ENG-ELSAYED-KANDIL/Scara-Robot/README.md

SCARA Robot (PRRR Configuration)
-----------------------------------------
🌟 Overview
----------------------------------------
This repository contains the design, build process, and control of a 4-DoF SCARA robot. The robot features a prismatic joint and three revolute joints (PRRR configuration) and is designed for precise pick-and-place tasks. It includes a functional GUI, real-time control, and an Arduino-based system for motor control.

<p align="center">
  SCARA Robot 1
  &nbsp;&nbsp;&nbsp;
  SCARA Robot 2
</p>

<p align="center"><strong>Figure 1: Final SCARA Robot</strong></p>

---
## 📖 1. Introduction  
This project focuses on building and analyzing a **SCARA (PRRR)** robot arm with **4 Degrees of Freedom (DoF)**. It combines both kinematic analysis and practical implementation, including calculations for forward kinematics, inverse kinematics, and Jacobian analysis. The project culminates in a demonstration where the robot performs precise pick-and-place tasks and can **hold objects weighing up to 1 kg**.

**This SCARA robot is developed for industrial pick-and-place applications.**  
The manipulator consists of:  
- **A prismatic joint** for vertical motion.  
- **Three revolute joints** for horizontal movements and rotation.  
- **A gripper** for handling square and round objects.  

The robot is controlled using an Arduino Uno and stepper motors through a CNC shield. The GUI simplifies user interaction, making the robot versatile for various tasks.  

---

## 🎯 2. Final Outcome  
The SCARA robot successfully performs pick-and-place tasks with smooth motion and precise control.  

https://github.com/user-attachments/assets/d78f2b1c-fb58-49c8-8bde-6cf13d8ed10f

*Figure 2: Final Robot Outcome*  

------
## 🔌 3. Wiring  

<p align="center">
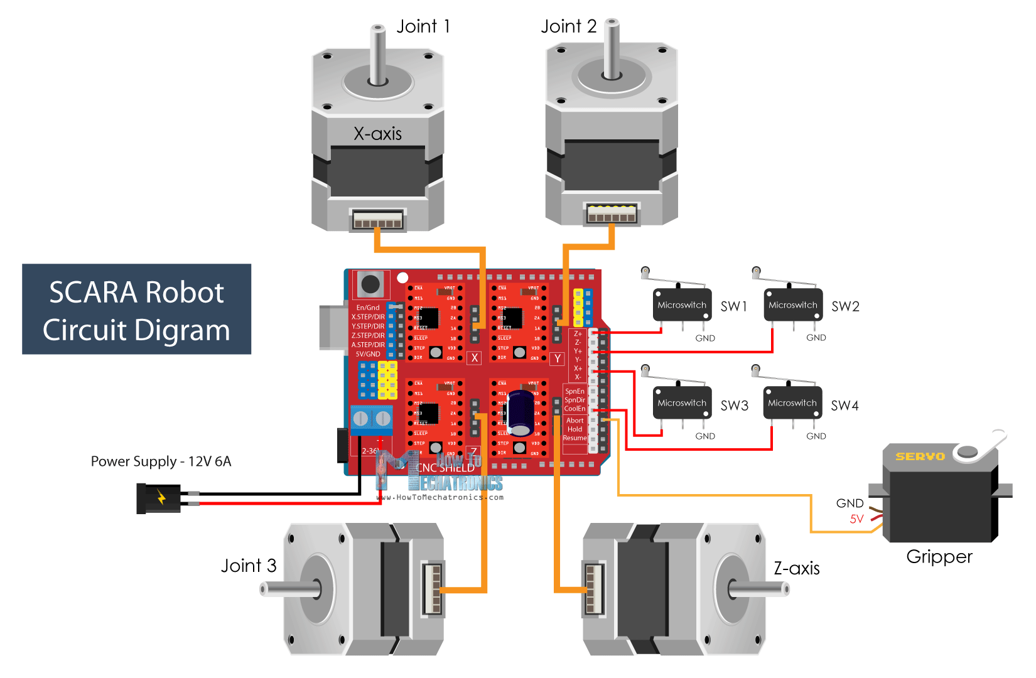
[picture p1: Pictures/Wiring.png]
  
</p>
<p align="center">
    <em>Figure 5: SCARA Robot main wiring diagram  </em>
</p>
<p align="center"> <em> Credit - how to mechatronics </em> </p>
 
The wiring connects stepper motors, the CNC shield, and the Arduino Uno. Here are the main considerations and steps followed:  

### **3.1 Motor Silence and Calibration**  
In wiring, I primarily focused on reducing motor noise. To achieve smooth motor operation, the current limit of the motor drivers was carefully adjusted. This calibration ensures precise motor activation. Setting an incorrect value can cause the motor drivers to overheat and potentially damage them. To further enhance motor precision, I adjusted the precision selector to 1/4 or 1/8 microstepping.

### **3.2 Connections and Testing**  
I connected the motor wiring as shown in the diagram and tested the connections with an oscilloscope and multimeter. Limit switches were placed at the corners of the joints' movement range to allow maximum rotational angles. After placing the limit switches, I assigned the pins for X+, Y+, Z+, and coolant functionalities.  

### **3.3 Servo Motor Powering**  
Since servo motors require a stable current, I initially tested them using the Arduino Uno with the CNC shield. However, the servo motor only received 3V from this setup, which was insufficient. To address this, I powered the servo motor separately using a 5V power supply.  

### **3.4 Power Supply Configuration**  
To power the entire system, which includes:  
- Four NEMA 17 stepper motors  
- Arduino Uno with CNC shield  
- Four motor drivers (DRV8825)  
- A servo motor  

I decided to use a 12V 10A power supply. A 12V 5A power supply would not have been sufficient to run all motors simultaneously.  

### **3.5 Cable Management**  
For clean and organized wiring, I used “Spiral Wire Wrapping Tube Cable Sleeves” and secured them with tie tags. This arrangement keeps the wires neat and minimizes clutter.  

### **3.6 Testing**  
To test all motors, I used simple Arduino code to verify their operation. This helped ensure that the motors, limit switches, and control pins were functioning as expected.  

### **3.7 Key Points**  
- **Shielded cables** were used for stepper motors to reduce electrical noise.  
- Correct polarity was ensured to avoid reversing motor directions.  
- The 12V DC power supply provided reliable power for the entire system.  

---

## 🏠 4. Homing Sequence
The homing sequence ensures that the robot starts from a known position:  

- The prismatic joint retracts to the lowest position.  
- Each revolute joint rotates to its home angle.  
- Limit switches provide feedback to confirm positions.  

As you can see in the video, the homing sequence begins with the gripper motor (joint 3). To determine the homing position, I used limit switches along with the following code:  
---

## 🏠 4. Homing Sequence
The homing sequence ensures that the robot starts from a known position:  

- The prismatic joint retracts to the lowest position.  
- Each revolute joint rotates to its home angle.  
- Limit switches provide feedback to confirm positions.  

As you can see in the video, the homing sequence begins with the gripper motor (joint 3). To determine the homing position, I used limit switches along with the following code:  

```cpp
//HOMING PROCESS
void homeRobot() {
  delay(1000);
  homeStepper2();
  homeStepper1();
  homeStepper3();
  homeStepperZ();
  isHomed = true;
  Serial.println("oK");
}

// joint 1
void homeStepper1() {
  stepper1.setCurrentPosition(0);
  stepper1.setSpeed(-1100);

  while (digitalRead(X_LIMIT_MIN) == 1) {
    stepper1.runSpeed();
  }

  delay(20);

  stepper1.setCurrentPosition(-maxDistance1);

  stepperPosition1 = 0;
  stepper1.moveTo(stepperPosition1);

  while (stepper1.currentPosition() != stepperPosition1) {
    stepper1.run();
  }

}

void homeStepper2() {
  stepper2.setCurrentPosition(0);
  stepper2.setSpeed(-1300);

  while (digitalRead(Y_LIMIT_MIN) == 1) {
    stepper2.runSpeed();
  }

  delay(20);

  stepper2.setCurrentPosition(-maxDistance2);

  stepperPosition2 = 0;
  stepper2.moveTo(stepperPosition2);

  while (stepper2.currentPosition() != stepperPosition2) {
    stepper2.run();
  }

}

//joint 3
void homeStepper3() {
  stepper3.setCurrentPosition(0);
  stepper3.setSpeed(-1300);

  while (digitalRead(GRIPPER_LIMIT) == 1) {
    stepper3.runSpeed();
  }

  delay(20);

  stepper3.setCurrentPosition(-maxDistance3);

  stepperPosition3 = 0;
  stepper3.moveTo(stepperPosition3);

  while (stepper3.currentPosition() != stepperPosition3) {
    stepper3.run();
  }
}

void homeStepperZ() {
  stepperZ.setCurrentPosition(0);
  stepperZ.setSpeed(1100);

  while (digitalRead(Z_LIMIT_MIN) == 1) {
    stepperZ.runSpeed();
  }

  delay(20);
  stepperZ.setCurrentPosition(0); /// max distance

  stepperZ.moveTo(maxDistanceZ); // 55 mm

  while (stepperZ.currentPosition() != maxDistanceZ) {
    stepperZ.run();
  }

}

```
**Homing** - https://github.com/ENG-ELSAYED-KANDIL/Scara-Robot/blob/main/Videos/WhatsApp%20Video%202025-06-26%20at%207.13.10%20PM.mp4
---
## 🧩 5. Pick and Place Application
The robot is programmed to pick objects from a defined source and place them in a target location.  

- Move to the pick position using the prismatic and revolute joints.  
- Grip the object using the servo-controlled gripper.  
- Transition to the target location and release the object.  

In the pick-and-place application, I saved 8 waypoints starting from its home position. Using the GUI, I configured these waypoints, which helped to better understand the movement of the joints and the gripper. After saving the waypoints and running the sequence, I achieved the following output:  

**Pick and Place Output** - https://github.com/ENG-ELSAYED-KANDIL/Scara-Robot/blob/main/Videos/pick%20%26%20place.mp4
---

## 🖥️ 6.**Graphical User Interface (GUI)**

<p align="center">
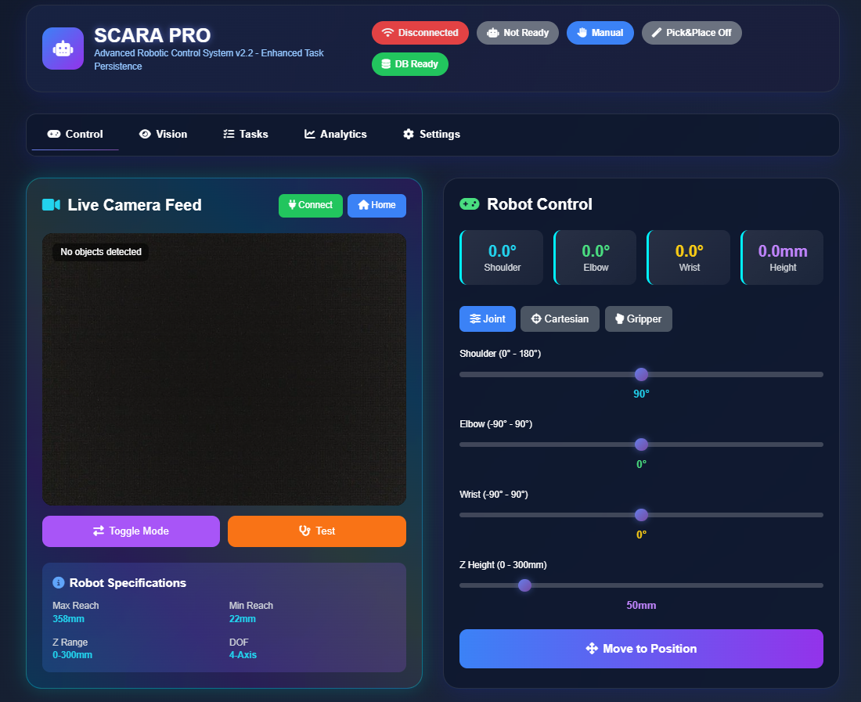
[picture p2: SCARA_ROBOT_GUI2/11.png]
SCARA Robot
  
</p>

A user-friendly GUI was developed using **Python**, designed to facilitate intuitive control and monitoring of the SCARA robot.

---

### **🔧 Key Features**

- 🎚️ **Joint Control**  
  Control robot joints individually using interactive sliders and buttons.

- 🎯 **End-Effector Positioning**  
  Direct control of the end-effector through coordinate input (X, Y, Z).

- 🎥 **Object Detection via Camera**  
  Real-time object detection using an integrated camera feed.

- 🧠 **Task Sequencing**  
  Ability to assign a sequence of tasks for the robot to execute automatically.

- 📈 **Real-Time Feedback**  
  Continuous monitoring of joint angles and current position.

- 🤖 **Gripper Control**  
  Open and close the gripper through simple GUI buttons.

---
## 🖨️ 7. 3D Printed Parts

The robot's design relies heavily on 3D-printed components, with over 100 hours of printing time invested to produce these parts. Each part was carefully designed to ensure functionality and precision:  

- **Gears**: Over seven different types of gears were printed to enable precise torque transfer and smooth motion across the joints.  
- **Link Components**: Critical parts for Link 1, Link 2, and Link 3 were printed to form the main structure of the robotic arm, allowing for stable and accurate joint movements.  
- **Z Holder**: This component supports the prismatic joint, ensuring reliable vertical motion and alignment.  
- **Limit Switch Contactors**: Custom 3D-printed parts that interact with limit switches to facilitate homing and accurate position detection.  
- **Gripper Mechanism**: Includes the gripping claws and structural supports necessary for securely holding objects during operation.  
- **Support Structures**: Temporary structures were printed alongside the main components to maintain the integrity of complex shapes during the printing process.  

These parts were printed using PLA+ material for durability and dimensional accuracy. All STL files are organized and available in the `/3D-Printed-Parts.rar` folder for easy access and replication.  

---

## 🔗 8. Code Explanation
The robot is programmed using Arduino Uno, with future plans to transition to AVR register-based programming for enhanced control. The key programming aspects include:  

- **Forward Kinematics**: Calculates the end-effector position based on joint values, ensuring precise movement to desired coordinates.  
- **Inverse Kinematics**: Determines joint angles for a given position, enabling accurate trajectory planning for the robot arm.  
- **DH Table and Jacobian Matrix**: The Denavit-Hartenberg (DH) parameters were derived to construct the transformation matrix, while the manipulator Jacobian was calculated to analyze joint velocities and forces.  
- **Control Algorithms**: Implements control for stepper motors, including speed adjustments and precise motion handling.  
- **Gripper Control**: Manages the servo-controlled gripper to open and close efficiently based on commands.  

To facilitate communication between the computer and the Arduino Uno, serial communication was established at a baud rate of 115200. This allows for easy command input and real-time control without needing to manually alter the code for each operation.  

Future iterations will focus on optimizing the code and exploring advanced microcontroller programming techniques for better performance.  

---

## 🎛️  9. Robot Details and Calculations

### **9.1 Link Dimensions and Specifications**  
The SCARA robot has **4 Degrees of Freedom (DoF)** with a **PRRR joint configuration**.  

**Link Dimensions**:  
- a1 = 150.8mm — Link 1 length  
- a2 = 190mm — Link 2 length  
- a3 = 160mm — Link 3 length  
- d4 = 600mm — Prismatic joint length   

### **9.2 Coordinate Frame Assignment**  
The following figure illustrates the coordinate frame assignment for the SCARA PRRR robot, adhering to the Denavit-Hartenberg (DH) convention:  

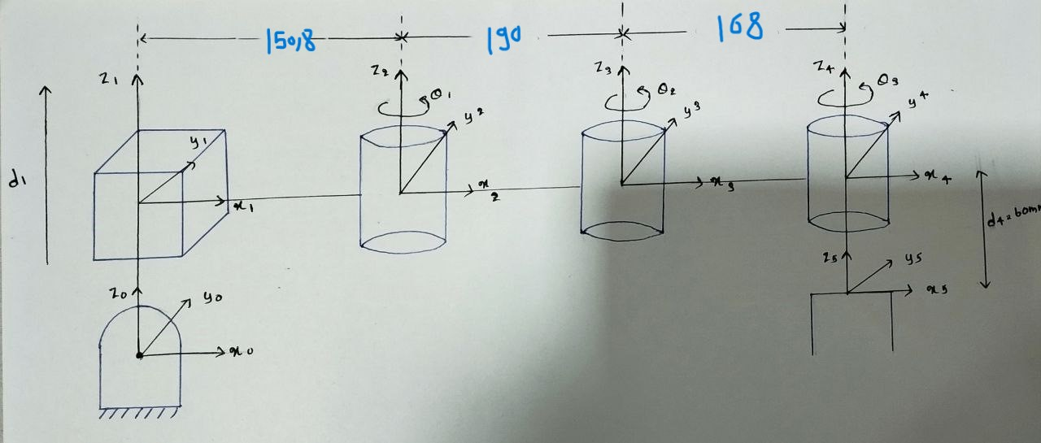
[picture p3: Pictures/Coordinate Frames.jpg]
Coordinate Frame Assignment
  

### **9.3 DH Table**  
The table below summarizes the DH parameters for the SCARA PRRR robot:  

| **Joint (i)** | **aᵢ (mm)** | **αᵢ (°)** | **dᵢ (mm)** | **θᵢ (°)** |
|---|---|---|---|---|
| 1 (Prismatic) | 0 | 0 | d₁ (variable) | 0 |
| 2 (Revolute) | 150.8 | 0 | 0 | θ₁ (variable) |
| 3 (Revolute) | 190 | 0 | 0 | θ₂ (variable) |
| 4 (Revolute) | 160 | 0 | 0 | θ₃ (variable) |
| 5 | 0 | 0 | 600 | 0 |

### **9.4Forward Kinematics**

Forward kinematics calculates the position and orientation of the end-effector based on the joint angles and link lengths. Using Denavit-Hartenberg (DH) parameters, we define the transformation matrix for each joint. The transformation matrix is:

<p align="center">
  SCARA Robot
</p>
By multiplying the individual transformation matrices from base to end-effector, we get the final transformation matrix T . This matrix provides the position (x, y, z) and the orientation of the end-effector. The angles θ1, θ2, and θ3 are used to determine the robot’s orientation in space.

<p align="center">
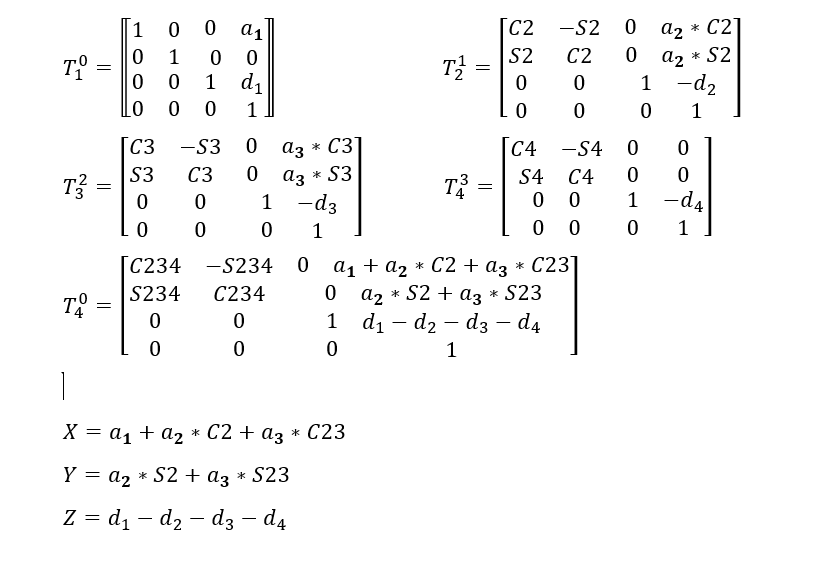
[picture p4: Pictures/forward.png]
  
</p>

### **9.5Inverse Kinematics**

Inverse kinematics determines the required joint angles based on the desired position of the end-effector. Given the end-effector's target position (x, y, z), and using the known link lengths, we calculate the angles θ₁, θ₂, and the displacement d₄ (for prismatic joints if applicable).

The inverse kinematics process involves solving geometric equations or using trigonometric identities to find the joint variables that place the end-effector at the desired location. For a SCARA robot, this typically involves solving for:

θ₁ and θ₂ using planar geometry in the x-y plane

d₄ from the z-position of the end-effector

<p align="center">
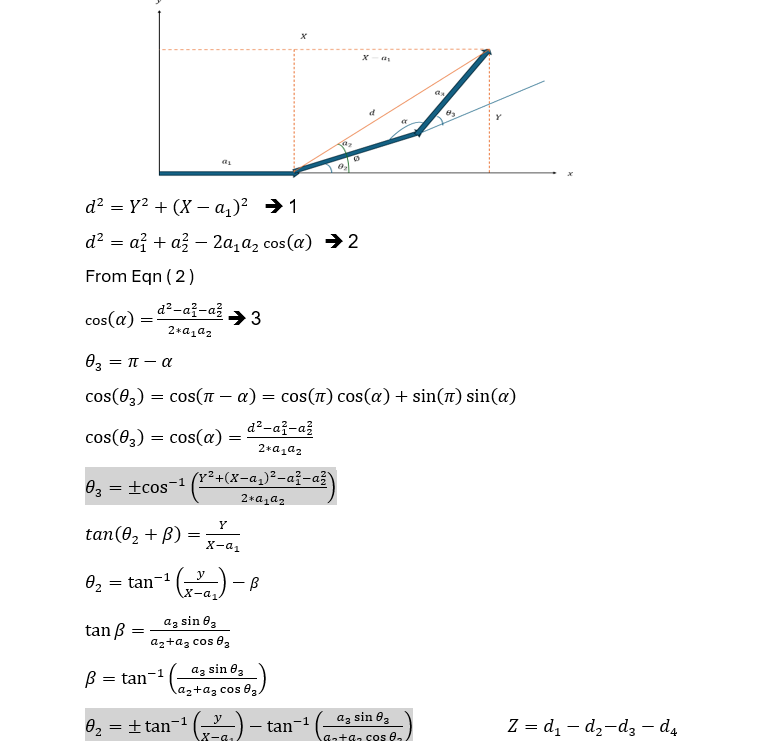
[picture p5: Pictures/inverse.png]
  
</p>

The Jacobian is derived using the partial derivatives of the forward kinematics equations.  

### **9.6Manipulator Jacobian Matrix**
The Jacobian matrix relates joint velocities to end-effector velocities. It is essential for analyzing the robot’s motion and controlling its speed and acceleration. For a PRRR manipulator, the Jacobianmatrix has two parts:

- Linear Velocity: The part of the Jacobian that maps joint velocities to linear velocities of the end-effector. It involves the cross product between the joint axes and the position vector.
- Angular Velocity: The part that maps joint velocities to angular velocities.

The Jacobian for the SCARA robot is given by:

<p align="center">
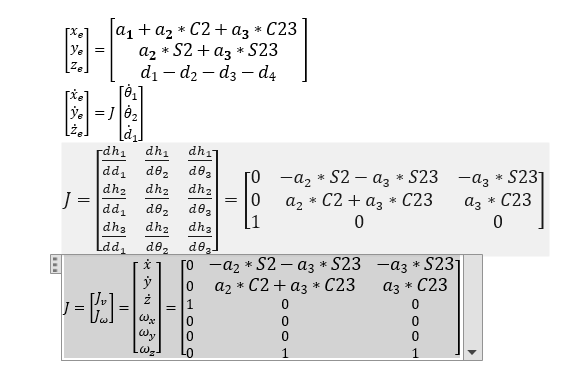
[picture p6: Pictures/jacobian.png]
  
</p>

### **9.6Dynamics Equations**



The solution is here :[Link](https://github.com/ENG-ELSAYED-KANDIL/Scara-Robot/blob/main/kinematics%20and%20Dynamics%20by%20write/dynamics.pdf) 

### **9.7Computed Torque Control**
Computed Torque Control is a model-based control strategy used to control the motion of robotic manipulators. The key idea behind CTC is to compensate for the robot's dynamics by applying the necessary torques at the joints to achieve a desired trajectory.
CTC involves:
Trajectory Planning: A desired trajectory or reference trajectory is defined for the robot, usually in terms of joint angles, velocities, and accelerations.
Inverse kinematics: Inverse kinematics is used to calculate the joint angles required to achieve a specific end-effector position. Small errors in these calculations can lead to significant deviations in the robot's movement.
Modeling Dynamics: The robot's dynamics are modeled, typically using the inverse dynamics equations. This allows for the computation of the torques required to track the desired trajectory.
Feedback Control: A feedback loop is used to adjust the control input in real-time. The control input typically involves both the desired torques (calculated from the inverse dynamics) and any necessary feedback gains (like PD or PID control).
Forward kinematics : used to calculate the final position and orientation of the robot's end-effector based on the angles or displacements of each joint in the robotic arm.

### **9.8Simulink Simulation**


System Simulation:

https://github.com/user-attachments/assets/358b40ac-75ad-4ba7-8ce4-bd9f127024b1

---

## 🤖 10. References  
- SCARA Robot Design Basics: [Link](https://en.wikipedia.org/wiki/SCARA)
- SCARA Robot Design Basics2: [Link](https://github.com/ENG-ELSAYED-KANDIL/Scara-Robot/upload/main)  
- Arduino CNC Shield Documentation: [Link](https://www.aranacorp.com/en/using-an-arduino-cnc-shield-v3)  
- SCARA Robot | How To Build Your Own Arduino Based Robot: [Link](https://youtu.be/1QHJksTrk8s?si=geVqN3zxPEzTnQR-)

---

Feel free to raise issues or contribute improvements to this project!
