ENG-ELSAYED-KANDIL/Scara-Robot/kinematics and Dynamics by write/inverse.pdf

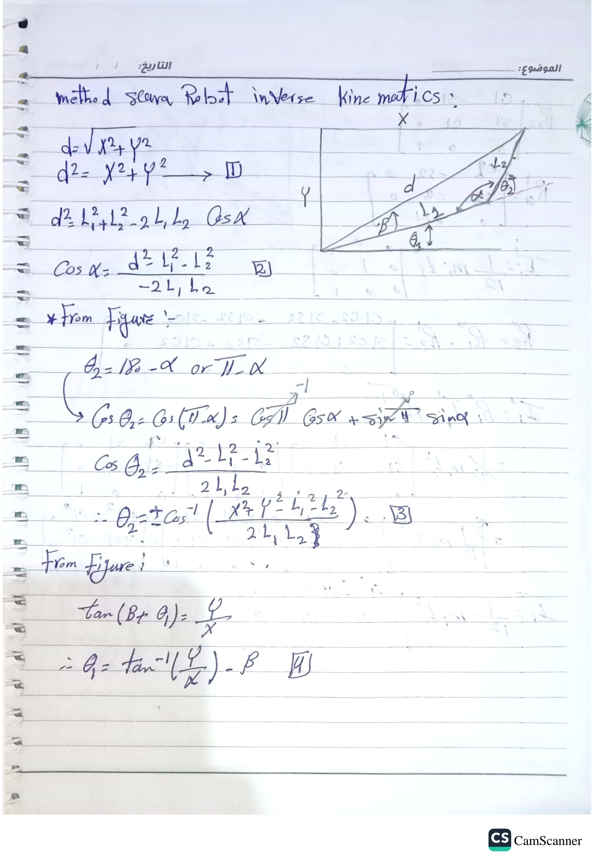
[picture p7: page 1]

CamScanner (https://v3.camscanner.com/user/download)

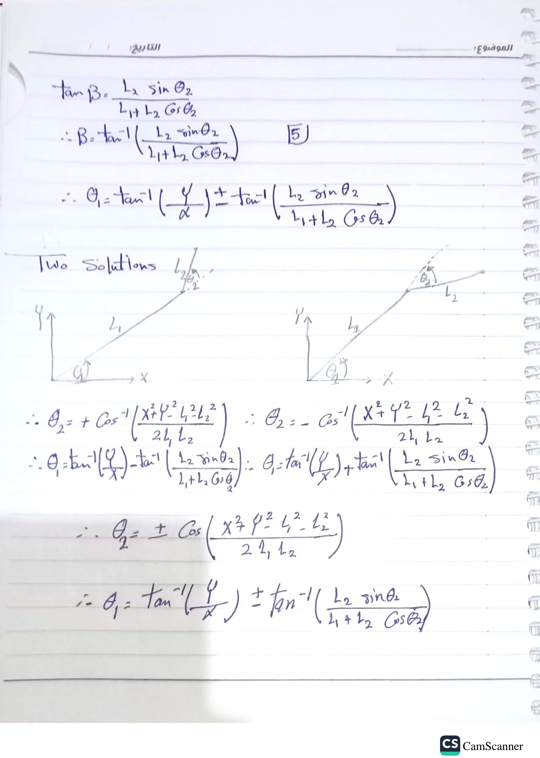
[picture p8: page 2]

CamScanner (https://v3.camscanner.com/user/download)
