ENG-ELSAYED-KANDIL/Scara-Robot/Pictures/photo_2025-07-09_03-17-51.jpg

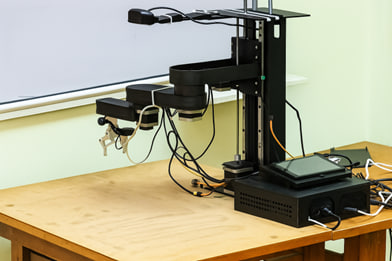
Pictures/photo_2025-07-09_03-17-51.jpg
