ENG-ELSAYED-KANDIL/Scara-Robot/Pictures/photo_2025-07-09_17-01-57.jpg

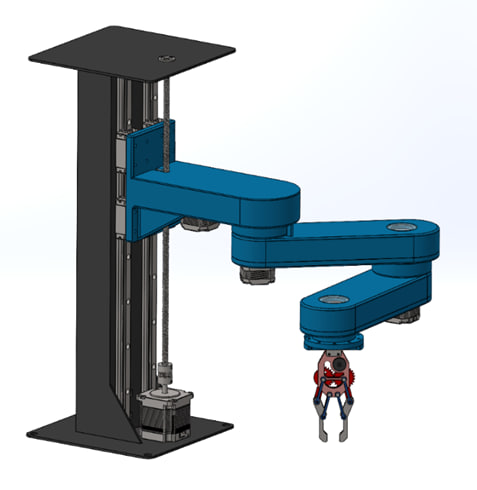
Pictures/photo_2025-07-09_17-01-57.jpg
