ENG-ELSAYED-KANDIL/Scara-Robot/Pictures/photo_2025-07-09_17-06-35.jpg

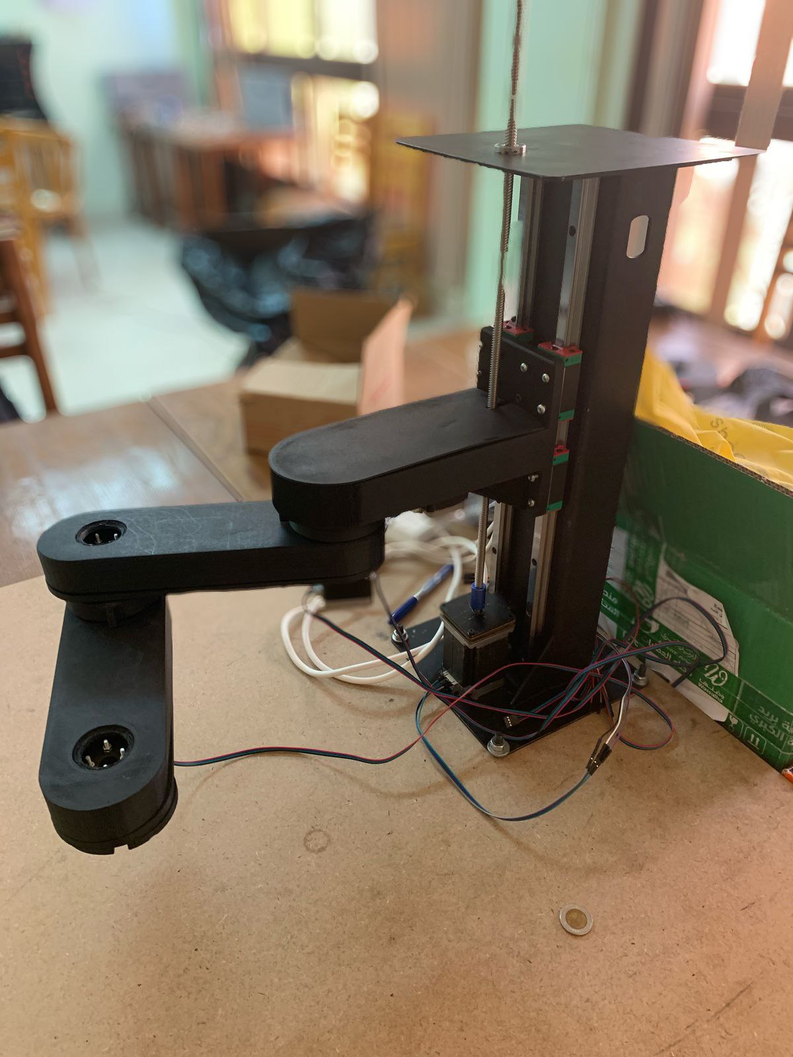
Pictures/photo_2025-07-09_17-06-35.jpg
