ENG-ELSAYED-KANDIL/Scara-Robot/SCARA_ROBOT_GUI1/scara_GUI.png

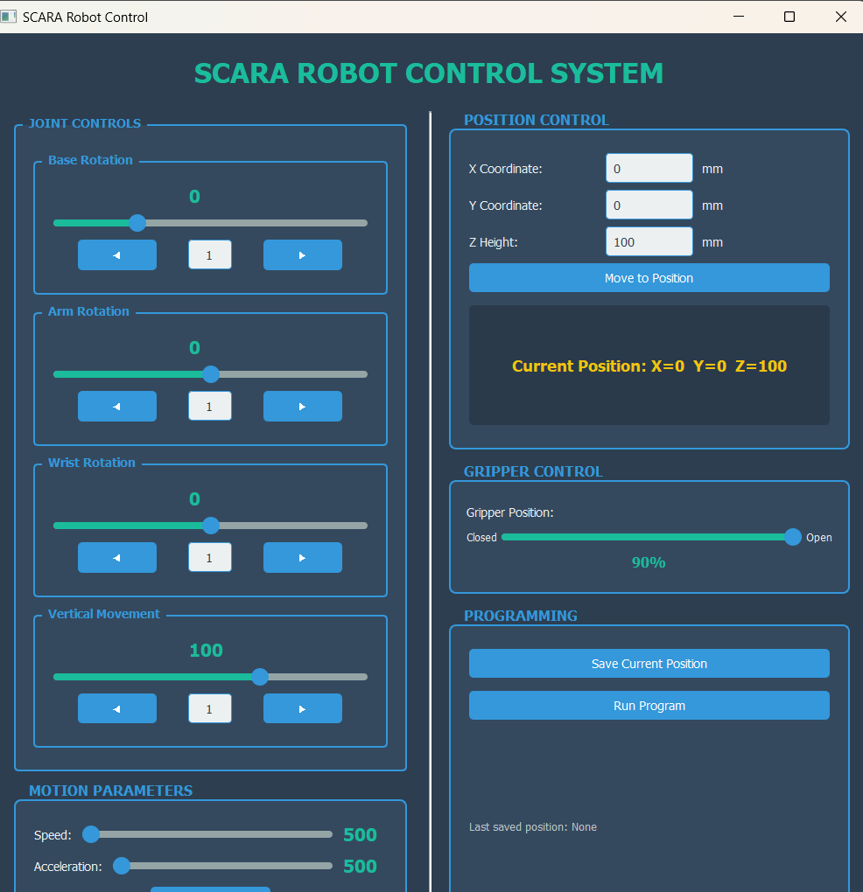
SCARA_ROBOT_GUI1/scara_GUI.png
