ENG-ELSAYED-KANDIL/Scara-Robot/SCARA_ROBOT_GUI2/1.png

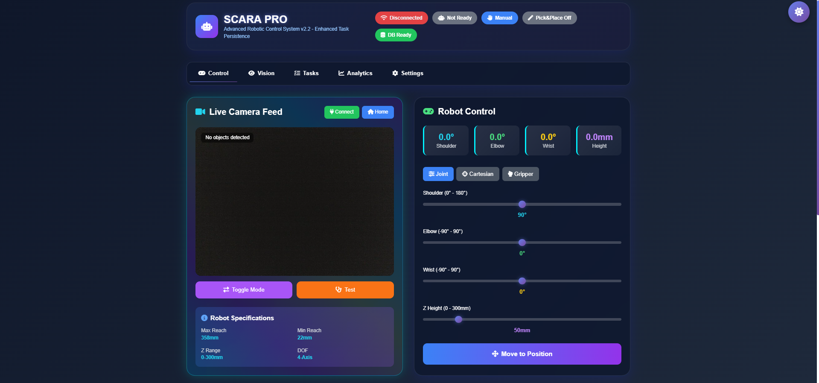
SCARA_ROBOT_GUI2/1.png
