ENG-ELSAYED-KANDIL/Scara-Robot/SCARA_ROBOT_GUI2/2.png

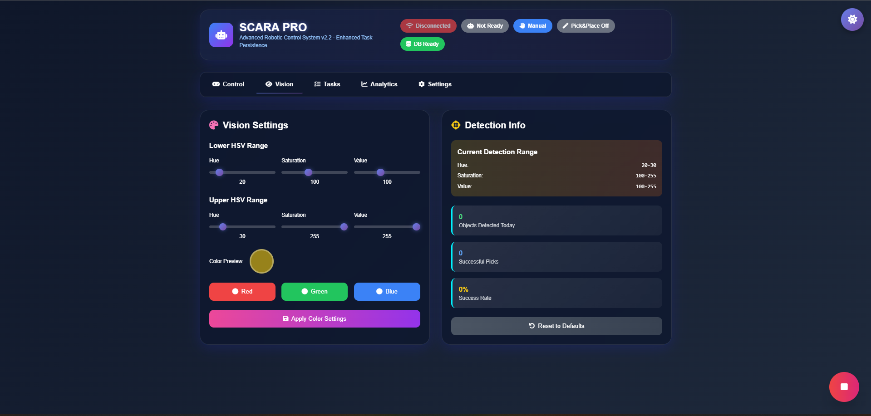
SCARA_ROBOT_GUI2/2.png
