ENG-ELSAYED-KANDIL/Scara-Robot/SCARA_ROBOT_GUI2/3.png

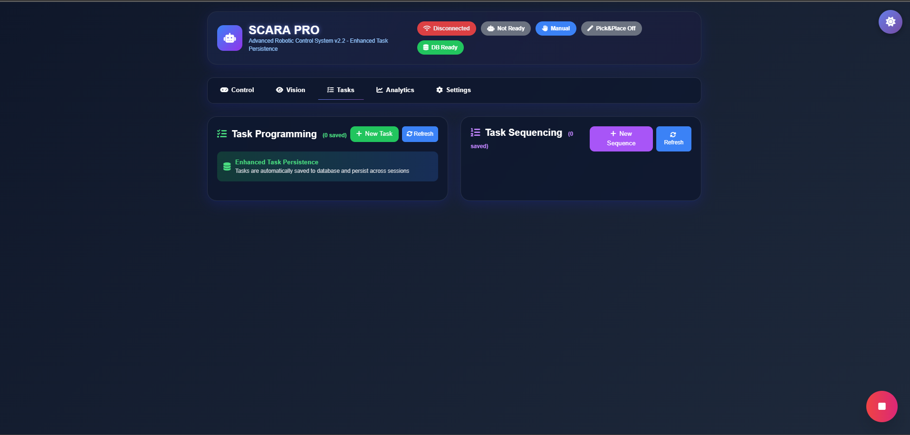
SCARA_ROBOT_GUI2/3.png
