ENG-ELSAYED-KANDIL/Scara-Robot/SCARA_ROBOT_GUI2/4.png

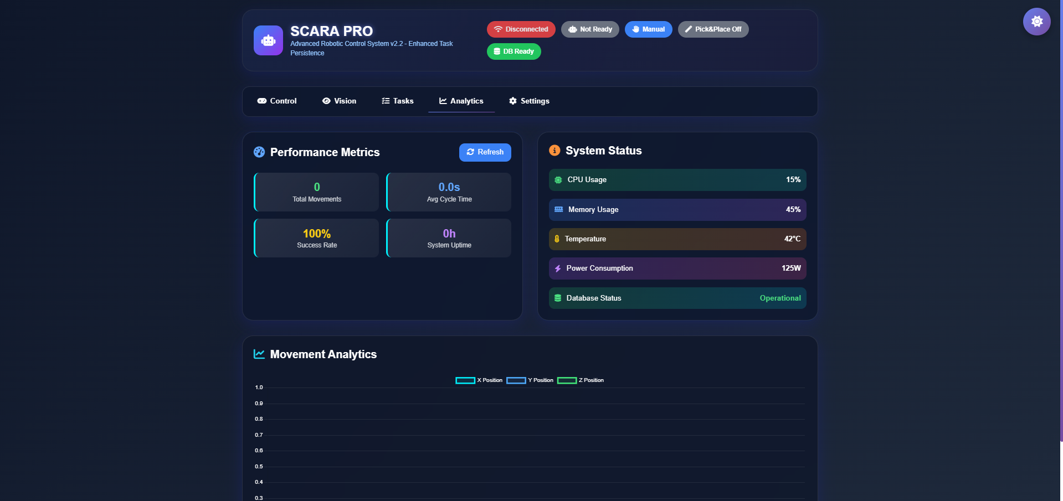
SCARA_ROBOT_GUI2/4.png
