ENG-ELSAYED-KANDIL/Scara-Robot/SCARA_ROBOT_GUI2/5.png

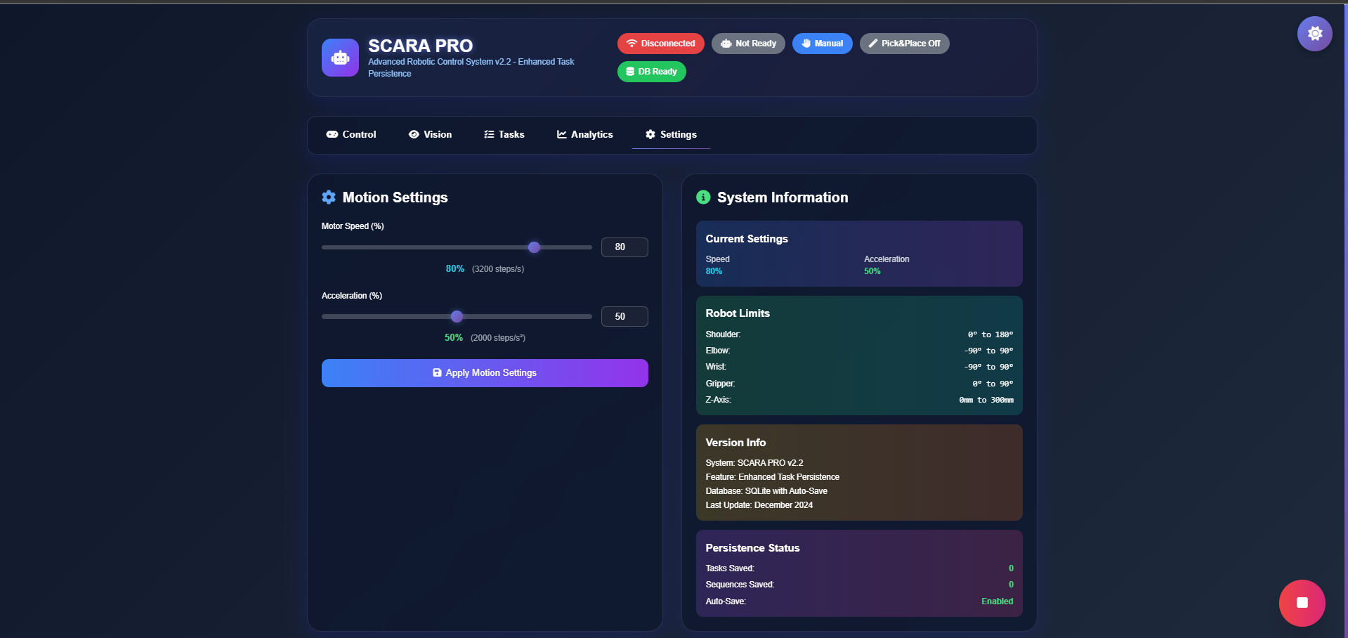
SCARA_ROBOT_GUI2/5.png
