ENG-ELSAYED-KANDIL/Scara-Robot/SCARA_ROBOT_GUI2/main.py

import asyncio
import json
import logging
import math
import sqlite3
import threading
import time
from dataclasses import dataclass, asdict
from datetime import datetime
from pathlib import Path
from typing import Dict, List, Optional, Tuple, Any
import queue

import cv2
import numpy as np
import serial
from flask import Flask, Response, jsonify, request, render_template_string
from flask_socketio import SocketIO, emit
import matplotlib

matplotlib.use('Agg')
import matplotlib.pyplot as plt
from matplotlib.backends.backend_agg import FigureCanvasAgg
import io
import base64

# Try to import numpy for kinematics calculations
try:
    import numpy as np

    NUMPY_AVAILABLE = True
except ImportError:
    NUMPY_AVAILABLE = False
    print("Warning: NumPy not available. Some kinematics functions may not work properly.")


@dataclass
class RobotConfig:
    """Robot physical configuration"""
    arm1_length: float = 190.0
    arm2_length: float = 168.0
    max_z_height: float = 300.0  # Updated to 300mm
    steps_per_degree: float = 8.888
    steps_per_mm_z: float = 80.0

    @property
    def max_reach(self) -> float:
        return self.arm1_length + self.arm2_length

    @property
    def min_reach(self) -> float:
        return abs(self.arm1_length - self.arm2_length)


@dataclass
class MotionSettings:
    """Motion control settings"""
    max_speed: int = 80  # Percentage (0-100)
    acceleration: int = 50  # Percentage (0-100)
    jog_speed: int = 800
    approach_speed: int = 500
    safety_limits_enabled: bool = True

    # Actual speed/acceleration values for display
    @property
    def actual_speed(self) -> float:
        """Convert percentage to actual steps/second (0-4000)"""
        return (self.max_speed / 100.0) * 4000.0

    @property
    def actual_acceleration(self) -> float:
        """Convert percentage to actual steps/second² (0-4000)"""
        return (self.acceleration / 100.0) * 4000.0


@dataclass
class VisionSettings:
    """Computer vision settings"""
    camera_index: int = 0
    resolution: Tuple[int, int] = (640, 480)
    hsv_lower: List[int] = None
    hsv_upper: List[int] = None
    blur_kernel: int = 5
    min_contour_area: int = 500
    calibration_matrix: Optional[np.ndarray] = None

    def __post_init__(self):
        if self.hsv_lower is None:
            self.hsv_lower = [20, 100, 100]
        if self.hsv_upper is None:
            self.hsv_upper = [30, 255, 255]


@dataclass
class SystemState:
    """Current system state"""
    is_connected: bool = False
    is_homed: bool = False
    emergency_stop: bool = False
    motors_enabled: bool = False
    operation_mode: str = "manual"
    current_position: List[float] = None
    target_position: List[float] = None
    gripper_position: int = 0
    ultrasonic_distance: float = 0.0
    last_detection: Optional[Tuple[float, float]] = None
    system_errors: List[str] = None
    pick_and_place_enabled: bool = False
    is_executing_pickplace: bool = False
    is_executing_sequence: bool = False
    current_sequence_task: Optional[str] = None
    sequence_progress: Dict = None

    def __post_init__(self):
        if self.current_position is None:
            self.current_position = [0.0, 0.0, 0.0, 0.0]
        if self.target_position is None:
            self.target_position = [0.0, 0.0, 0.0, 0.0]
        if self.system_errors is None:
            self.system_errors = []
        if self.sequence_progress is None:
            self.sequence_progress = {
                'current_task': 0,
                'current_loop': 0,
                'total_loops': 0,
                'is_running': False,
                'is_paused': False
            }


@dataclass
class PickPlaceSettings:
    """Pick and place operation settings"""
    pick_z_height: float = 50.0
    drop_x: float = 20.0
    drop_y: float = 10.0
    drop_z: float = 20.0
    grip_position: int = 45  # Updated range 0-90
    open_position: int = 0
    pick_delay: float = 1.0
    drop_delay: float = 1.0
    approach_height: float = 80.0
    auto_mode: bool = False


class RobotController:
    """Main robot controller class with enhanced functionality"""

    def __init__(self, config: RobotConfig, port: str = '/dev/ttyUSB0', baudrate: int = 115200):
        self.config = config
        self.port = port
        self.baudrate = baudrate
        self.serial_connection: Optional[serial.Serial] = None
        self.command_queue = queue.Queue()
        self.response_queue = queue.Queue()
        self.is_running = False
        self.lock = threading.Lock()

        # Pick and place settings
        self.pickplace_settings = PickPlaceSettings()

        self.logger = logging.getLogger(__name__)

    async def connect(self) -> bool:
        """Establish connection to Arduino"""
        try:
            ports_to_try = ['/dev/ttyACM0', self.port, '/dev/ttyUSB0', '/dev/ttyUSB1', 'COM8', 'COM4', 'COM5']

            for port in ports_to_try:
                try:
                    self.logger.info(f"Attempting to connect to port: {port}")

                    self.serial_connection = serial.Serial(
                        port,
                        self.baudrate,
                        timeout=2.0,
                        write_timeout=2.0,
                        bytesize=serial.EIGHTBITS,
                        parity=serial.PARITY_NONE,
                        stopbits=serial.STOPBITS_ONE
                    )

                    await asyncio.sleep(3)

                    self.serial_connection.reset_input_buffer()
                    self.serial_connection.reset_output_buffer()

                    for attempt in range(3):
                        self.logger.info(f"Connection attempt {attempt + 1}/3")

                        response = await self.send_command("GET_STATUS", timeout=3.0)

                        if response and ("STATUS:" in response or "SCARA_READY" in response or "OK" in response):
                            self.is_running = True
                            self.port = port
                            self.logger.info(f"Successfully connected to robot on port {port}")
                            return True

                        response = await self.send_command("PING", timeout=2.0)
                        if response:
                            self.is_running = True
                            self.port = port
                            self.logger.info(f"Connected to device on port {port} (responded to PING)")
                            return True

                        await asyncio.sleep(1)

                    if self.serial_connection and self.serial_connection.is_open:
                        self.serial_connection.close()

                except serial.SerialException as se:
                    self.logger.warning(f"Failed to connect to {port}: {se}")
                    if self.serial_connection and self.serial_connection.is_open:
                        self.serial_connection.close()
                    continue
                except Exception as e:
                    self.logger.warning(f"Unexpected error with port {port}: {e}")
                    if self.serial_connection and self.serial_connection.is_open:
                        self.serial_connection.close()
                    continue

            self.logger.error("Failed to connect to any serial port")

        except Exception as e:
            self.logger.error(f"Connection failed: {e}")

        return False

    async def disconnect(self):
        """Disconnect from Arduino"""
        self.is_running = False
        if self.serial_connection and self.serial_connection.is_open:
            self.serial_connection.close()
            self.logger.info("Disconnected from robot")

    async def send_command(self, command: str, timeout: float = 5.0) -> Optional[str]:
        """Send command to Arduino and wait for response"""
        if not self.serial_connection or not self.serial_connection.is_open:
            return None

        try:
            with self.lock:
                self.serial_connection.reset_input_buffer()

                self.serial_connection.write(f"{command}\n".encode('utf-8'))
                self.serial_connection.flush()

                start_time = time.time()
                while time.time() - start_time < timeout:
                    if self.serial_connection.in_waiting > 0:
                        try:
                            raw_data = self.serial_connection.readline()

                            try:
                                response = raw_data.decode('utf-8').strip()
                            except UnicodeDecodeError:
                                try:
                                    response = raw_data.decode('latin-1').strip()
                                    self.logger.warning(f"Used latin-1 encoding for response: {response}")
                                except UnicodeDecodeError:
                                    response = raw_data.decode('utf-8', errors='ignore').strip()
                                    self.logger.warning(f"Ignored decode errors for response: {response}")

                            if response:
                                self.logger.debug(f"Command: {command} -> Response: {response}")
                                return response

                        except Exception as decode_error:
                            self.logger.error(f"Response decode error: {decode_error}")
                            continue

                    await asyncio.sleep(0.01)

        except Exception as e:
            self.logger.error(f"Command send error: {e}")

        return None

    async def home_robot(self) -> bool:
        """Home the robot to its reference position"""
        self.logger.info("Starting homing sequence")

        response = await self.send_command("HOME", timeout=30.0)

        if response:
            self.logger.debug(f"Homing response: {response}")

            if any(keyword in response for keyword in ["OK", "HOMING COMPLETED", "HOME COMPLETE", "HOMED"]):
                self.logger.info("Homing completed successfully")
                return True
            elif "ERROR" in response:
                self.logger.error(f"Homing failed with error: {response}")
                return False
            elif "INFO" in response or "WARNING" in response:
                self.logger.info(f"Homing in progress: {response}")

                final_response = await self.send_command("GET_STATUS", timeout=5.0)
                if final_response and "homed=1" in final_response:
                    self.logger.info("Homing completed (confirmed via status)")
                    return True
                else:
                    self.logger.warning("Homing status unclear, but proceeding")
                    return True
            else:
                self.logger.warning(f"Unexpected homing response: {response}")
                return True
        else:
            self.logger.error("No response received from homing command")
            return False

    async def move_joint(self, shoulder: float, elbow: float, wrist: float, z: float) -> bool:
        """Move robot using joint coordinates with updated limits"""
        self.logger.info(f"Attempting joint movement: S={shoulder:.2f}°, E={elbow:.2f}°, W={wrist:.2f}°, Z={z:.2f}mm")

        # Updated validation ranges
        if not (0 <= shoulder <= 180):  # Updated: 0 to 180 degrees
            self.logger.error(f"Shoulder angle {shoulder}° out of range (0 to 180)")
            return False
        if not (-90 <= elbow <= 90):  # Same as before
            self.logger.error(f"Elbow angle {elbow}° out of range (-90 to 90)")
            return False
        if not (-90 <= wrist <= 90):  # Updated: -90 to 90 degrees
            self.logger.error(f"Wrist angle {wrist}° out of range (-90 to 90)")
            return False
        if not (0 <= z <= 300):  # Updated: 0 to 300 mm
            self.logger.error(f"Z height {z}mm out of range (0 to 300)")
            return False

        command = f"MOVE_JOINT S{shoulder:.2f} B{elbow:.2f} W{wrist:.2f} Z{z:.2f}"
        self.logger.debug(f"Sending command: {command}")

        response = await self.send_command(command, timeout=10.0)

        if response:
            self.logger.debug(f"Robot response: {response}")
            if "OK" in response:
                self.logger.info("Joint movement successful")
                return True
            elif "ERROR" in response:
                self.logger.error(f"Robot reported error: {response}")

                if "not homed" in response.lower():
                    self.logger.info("Robot needs to be homed first")

                return False
            else:
                self.logger.warning(f"Unexpected response: {response}")
                return True
        else:
            self.logger.error("No response received from robot")
            return False

    async def move_cartesian(self, x: float, y: float, z: float) -> bool:
        """Move robot using Cartesian coordinates with improved inverse kinematics"""
        self.logger.info(f"Attempting Cartesian movement to: X={x:.2f}mm, Y={y:.2f}mm, Z={z:.2f}mm")

        # Calculate inverse kinematics
        success, theta1, theta2, phi, final_z = self.inverse_kinematics(x, y, z)

        if not success:
            self.logger.error(f"Cannot reach position ({x:.2f}, {y:.2f}, {z:.2f})")
            return False

        # Verify the solution with forward kinematics
        verify_x, verify_y = self.forward_kinematics(theta1, theta2, phi)
        error = math.sqrt((x - verify_x) ** 2 + (y - verify_y) ** 2)

        if error > 4.0:  # Allow 4mm tolerance
            self.logger.warning(f"IK solution has {error:.4f}mm error")

        self.logger.info(
            f"IK Solution: Shoulder={theta1:.1f}°, Elbow={theta2:.1f}°, Wrist={phi:.1f}°, Error={error:.2f}mm")

        # Use the joint movement command with calculated angles
        return await self.move_joint(theta1, theta2, phi, final_z)

    async def control_gripper(self, position: int) -> bool:
        """Control gripper position with updated range (0-90 degrees)"""
        # Updated validation range
        if not (0 <= position <= 90):  # Updated: 0 to 90 degrees
            self.logger.error(f"Gripper position {position}° out of range (0 to 90)")
            return False

        command = f"GRIPPER {position}"
        response = await self.send_command(command)

        return response and "OK" in response

    async def set_motion_settings(self, speed: int, acceleration: int) -> bool:
        """Set motion speed and acceleration (percentages, converted to actual values)"""
        # Validate ranges (0-100 percentages)
        speed = max(0, min(100, speed))
        acceleration = max(0, min(100, acceleration))

        # Convert percentages to actual values for Arduino
        actual_speed = (speed / 100.0) * 4000.0
        actual_acceleration = (acceleration / 100.0) * 4000.0

        command = f"SET_MOTION SPEED{actual_speed:.0f} ACCEL{actual_acceleration:.0f}"
        response = await self.send_command(command)

        return response and "OK" in response

    # === IMPROVED INVERSE KINEMATICS IMPLEMENTATION ===

    def inverse_kinematics(self, x: float, y: float, z: float = None) -> Tuple[bool, float, float, float, float]:
        """
        Improved inverse kinematics for SCARA robot with corrected equations

        Args:
            x, y: Target Cartesian coordinates in mm
            z: Target Z height in mm (optional, defaults to current or 50mm)

        Returns:
            Tuple of (success, theta1, theta2, phi, z) where:
            - theta1: shoulder angle in degrees (0 to 180)
            - theta2: elbow angle in degrees (-90 to 90)
            - phi: gripper orientation angle in degrees (-90 to 90)
            - z: vertical position in mm (0 to 300)
        """
        try:
            # Use numpy if available, otherwise fall back to math
            if NUMPY_AVAILABLE:
                import numpy as np
                sqrt_func = np.sqrt
                clip_func = np.clip
                arccos_func = np.arccos
                arctan2_func = np.arctan2
                sin_func = np.sin
                cos_func = np.cos
                radians_func = np.radians
                degrees_func = np.degrees
            else:
                sqrt_func = math.sqrt

                def clip_func(val, min_val, max_val):
                    return max(min_val, min(max_val, val))

                arccos_func = math.acos
                arctan2_func = math.atan2
                sin_func = math.sin
                cos_func = math.cos
                radians_func = math.radians
                degrees_func = math.degrees

            # Robot arm lengths and limits
            L1 = self.config.arm1_length  # 190mm
            L2 = self.config.arm2_length  # 168mm
            MAX_REACH = L1 + L2  # 358mm
            MIN_REACH = abs(L1 - L2)  # 22mm

            # Set default Z if not provided
            if z is None:
                z = 50.0  # Default height

            # Validate Z height with new range
            if not (0 <= z <= self.config.max_z_height):
                self.logger.warning(f"Z height {z}mm out of range (0 to {self.config.max_z_height})")
                return False, 0.0, 0.0, 0.0, z

            # Check if point is reachable
            distance = sqrt_func(x * x + y * y)
            if distance > MAX_REACH or distance < MIN_REACH:
                self.logger.warning(f"Target position ({x}, {y}) is out of reachable workspace")
                return False, 0.0, 0.0, 0.0, z

            # Improved inverse kinematics calculation
            # Calculate elbow angle using law of cosines
            cos_theta2 = (distance * distance - L1 * L1 - L2 * L2) / (2 * L1 * L2)
            cos_theta2 = clip_func(cos_theta2, -1.0, 1.0)  # Ensure valid range for acos

            # Calculate two possible solutions for elbow
            theta2_1 = arccos_func(cos_theta2)  # Elbow up configuration
            theta2_2 = -arccos_func(cos_theta2)  # Elbow down configuration

            # Choose elbow configuration based on workspace
            theta2 = theta2_1 if theta2_1 <= math.pi / 2 else theta2_2

            # Calculate shoulder angle
            alpha = arctan2_func(y, x)
            beta = arctan2_func(L2 * sin_func(theta2), L1 + L2 * cos_func(theta2))
            theta1 = alpha - beta

            # Convert to degrees
            theta1_deg = degrees_func(theta1)
            theta2_deg = degrees_func(theta2)

            # Normalize shoulder angle to 0-180 range
            while theta1_deg < 0:
                theta1_deg += 360
            while theta1_deg > 180:
                theta1_deg -= 360

            # If still out of range, try the other elbow configuration
            if theta1_deg < 0 or theta1_deg > 180:
                theta2 = theta2_2 if theta2 == theta2_1 else theta2_1
                beta = arctan2_func(L2 * sin_func(theta2), L1 + L2 * cos_func(theta2))
                theta1 = alpha - beta
                theta1_deg = degrees_func(theta1)
                theta2_deg = degrees_func(theta2)

                # Normalize again
                while theta1_deg < 0:
                    theta1_deg += 360
                while theta1_deg > 180:
                    theta1_deg -= 360

            # Calculate wrist orientation (phi) to keep end-effector parallel to base
            # For a SCARA robot, phi should compensate for shoulder and elbow rotation
            phi = -(theta1_deg + theta2_deg)

            # Normalize phi to -90 to 90 range
            while phi > 90:
                phi -= 180
            while phi < -90:
                phi += 180

            # Round values for consistency
            theta1_deg = round(theta1_deg, 2)
            theta2_deg = round(theta2_deg, 2)
            phi = round(phi, 2)

            # Validate final angles are within joint limits
            if not (0 <= theta1_deg <= 180):
                self.logger.warning(f"Shoulder angle {theta1_deg}° out of range (0-180)")
                return False, 0.0, 0.0, 0.0, z

            if not (-90 <= theta2_deg <= 90):
                self.logger.warning(f"Elbow angle {theta2_deg}° out of range (-90-90)")
                return False, 0.0, 0.0, 0.0, z

            if not (-90 <= phi <= 90):
                self.logger.warning(f"Wrist angle {phi}° out of range (-90-90)")
                return False, 0.0, 0.0, 0.0, z

            self.logger.info(
                f"IK Solution: ({x:.1f}, {y:.1f}, {z:.1f}) -> Shoulder: {theta1_deg}°, Elbow: {theta2_deg}°, Wrist: {phi}°")
            return True, theta1_deg, theta2_deg, phi, z

        except Exception as e:
            self.logger.error(f"Inverse kinematics calculation error: {e}")
            return False, 0.0, 0.0, 0.0, z if z is not None else 50.0

    def forward_kinematics(self, shoulder_deg: float, elbow_deg: float, wrist_deg: float = 0.0) -> Tuple[float, float]:
        """
        Calculate forward kinematics for SCARA robot (verified and corrected)

        Args:
            shoulder_deg, elbow_deg, wrist_deg: Joint angles in degrees

        Returns:
            Tuple of (x, y) Cartesian coordinates in mm
        """
        try:
            # Use numpy if available, otherwise fall back to math
            if NUMPY_AVAILABLE:
                import numpy as np
                cos_func = np.cos
                sin_func = np.sin
                radians_func = np.radians
            else:
                cos_func = math.cos
                sin_func = math.sin
                radians_func = math.radians

            # Convert to radians
            theta1_rad = radians_func(shoulder_deg)
            theta2_rad = radians_func(elbow_deg)

            # Robot arm lengths
            L1 = self.config.arm1_length  # 190mm
            L2 = self.config.arm2_length  # 168mm

            # Calculate end effector position using improved SCARA forward kinematics
            x = L1 * cos_func(theta1_rad) + L2 * cos_func(theta1_rad + theta2_rad)
            y = L1 * sin_func(theta1_rad) + L2 * sin_func(theta1_rad + theta2_rad)

            return float(x), float(y)

        except Exception as e:
            self.logger.error(f"Forward kinematics calculation error: {e}")
            return 0.0, 0.0

    def is_position_reachable(self, x: float, y: float, z: float) -> bool:
        """
        Check if a given Cartesian position is reachable by the robot

        Args:
            x, y, z: Target position in mm

        Returns:
            bool: True if position is reachable, False otherwise
        """
        try:
            # Check Z limits
            if not (0 <= z <= self.config.max_z_height):
                return False

            # Check if XY position is within workspace
            distance = math.sqrt(x ** 2 + y ** 2)

            # Check against robot workspace limits
            max_reach = self.config.max_reach  # L1 + L2
            min_reach = self.config.min_reach  # |L1 - L2|

            if distance > max_reach or distance < min_reach:
                return False

            # Additional check: try inverse kinematics
            success, theta1, theta2, phi, _ = self.inverse_kinematics(x, y, z)

            # Verify angles are within joint limits
            if not success:
                return False

            if not (0 <= theta1 <= 180):
                return False
            if not (-90 <= theta2 <= 90):
                return False
            if not (-90 <= phi <= 90):
                return False

            return True

        except Exception as e:
            self.logger.error(f"Reachability check error: {e}")
            return False

    def validate_cartesian_position(self, x: float, y: float, z: float) -> bool:
        """Validate if Cartesian position is reachable (alias for is_position_reachable)"""
        return self.is_position_reachable(x, y, z)

    async def emergency_stop(self) -> bool:
        """Activate emergency stop"""
        response = await self.send_command("EMERGENCY_STOP")
        return response and "EMERGENCY_STOP_ACTIVATED" in response

    async def reset_emergency(self) -> bool:
        """Reset emergency stop"""
        response = await self.send_command("RESET_EMERGENCY")
        return response and "OK" in response

    async def get_status(self) -> Optional[Dict]:
        """Get current robot status"""
        response = await self.send_command("GET_STATUS")

        if response and "STATUS:" in response:
            try:
                status_data = response.replace("STATUS:", "")
                status_dict = {}

                for item in status_data.split(","):
                    if "=" in item:
                        key, value = item.split("=", 1)
                        status_dict[key.lower()] = value

                return status_dict
            except Exception as e:
                self.logger.error(f"Status parsing error: {e}")

        return None

    async def get_position(self) -> Optional[List[float]]:
        """Get current joint positions"""
        response = await self.send_command("GET_POSITION")

        if response and "POSITION:" in response:
            try:
                pos_data = response.replace("POSITION:", "")
                positions = []

                for item in pos_data.split(","):
                    if "=" in item:
                        _, value = item.split("=", 1)
                        positions.append(float(value))

                return positions
            except Exception as e:
                self.logger.error(f"Position parsing error: {e}")

        return None

    # === PICK AND PLACE FUNCTIONALITY (UPDATED WITH NEW LIMITS) ===

    async def pick_and_place(self, pick_x: float, pick_y: float, drop_x: Optional[float] = None,
                             drop_y: Optional[float] = None, drop_z: Optional[float] = None) -> bool:
        """
        Execute pick and place operation with updated position validation

        Args:
            pick_x, pick_y: Object pickup coordinates
            drop_x, drop_y, drop_z: Drop location (uses defaults if None)

        Returns:
            bool: True if operation successful
        """
        try:
            self.logger.info(f"Starting pick and place operation: pick({pick_x:.1f}, {pick_y:.1f})")

            # Use default drop location if not specified
            if drop_x is None:
                drop_x = self.pickplace_settings.drop_x
            if drop_y is None:
                drop_y = self.pickplace_settings.drop_y
            if drop_z is None:
                drop_z = self.pickplace_settings.drop_z

            # Validate coordinates using new reachability function
            if not self.is_position_reachable(pick_x, pick_y, self.pickplace_settings.pick_z_height):
                self.logger.error("Invalid pickup coordinates - position not reachable")
                return False

            if not self.is_position_reachable(drop_x, drop_y, drop_z):
                self.logger.error("Invalid drop coordinates - position not reachable")
                return False

            # Step 1: Approach above pickup position
            approach_z = max(self.pickplace_settings.pick_z_height + 30, self.pickplace_settings.approach_height)
            self.logger.info(f"Step 1: Moving to approach position ({pick_x:.1f}, {pick_y:.1f}, {approach_z:.1f})")

            success = await self.move_cartesian(pick_x, pick_y, approach_z)
            if not success:
                self.logger.error("Failed to move to approach position")
                return False

            await asyncio.sleep(0.5)  # Brief pause

            # Step 2: Move down to pickup position
            self.logger.info(f"Step 2: Moving down to pickup position (Z={self.pickplace_settings.pick_z_height:.1f})")
            success = await self.move_cartesian(pick_x, pick_y, self.pickplace_settings.pick_z_height)
            if not success:
                self.logger.error("Failed to move to pickup position")
                return False

            await asyncio.sleep(0.3)  # Brief pause

            # Step 3: Close gripper to pick up object
            self.logger.info(f"Step 3: Closing gripper to {self.pickplace_settings.grip_position}°")
            success = await self.control_gripper(self.pickplace_settings.grip_position)
            if not success:
                self.logger.error("Failed to close gripper")
                return False

            await asyncio.sleep(self.pickplace_settings.pick_delay)  # Wait for grip

            # Step 4: Lift object up
            self.logger.info(f"Step 4: Lifting object to approach height")
            success = await self.move_cartesian(pick_x, pick_y, approach_z)
            if not success:
                self.logger.error("Failed to lift object")
                return False

            await asyncio.sleep(0.5)  # Brief pause

            # Step 5: Move to drop location (approach height)
            drop_approach_z = max(drop_z + 30, self.pickplace_settings.approach_height)
            self.logger.info(
                f"Step 5: Moving to drop approach position ({drop_x:.1f}, {drop_y:.1f}, {drop_approach_z:.1f})")
            success = await self.move_cartesian(drop_x, drop_y, drop_approach_z)
            if not success:
                self.logger.error("Failed to move to drop approach position")
                return False

            await asyncio.sleep(0.5)  # Brief pause

            # Step 6: Move down to drop position
            self.logger.info(f"Step 6: Moving down to drop position (Z={drop_z:.1f})")
            success = await self.move_cartesian(drop_x, drop_y, drop_z)
            if not success:
                self.logger.error("Failed to move to drop position")
                return False

            await asyncio.sleep(0.3)  # Brief pause

            # Step 7: Open gripper to release object
            self.logger.info(f"Step 7: Opening gripper to {self.pickplace_settings.open_position}°")
            success = await self.control_gripper(self.pickplace_settings.open_position)
            if not success:
                self.logger.error("Failed to open gripper")
                return False

            await asyncio.sleep(self.pickplace_settings.drop_delay)  # Wait for release

            # Step 8: Lift up from drop position
            self.logger.info(f"Step 8: Lifting up from drop position")
            success = await self.move_cartesian(drop_x, drop_y, drop_approach_z)
            if not success:
                self.logger.error("Failed to lift from drop position")
                return False

            self.logger.info("Pick and place operation completed successfully!")
            return True

        except Exception as e:
            self.logger.error(f"Pick and place operation failed: {e}")
            return False

    def update_pickplace_settings(self, **kwargs):
        """Update pick and place settings with validation"""
        for key, value in kwargs.items():
            if hasattr(self.pickplace_settings, key):
                # Validate gripper positions
                if key in ['grip_position', 'open_position']:
                    value = max(0, min(90, int(value)))  # Clamp to 0-90 range
                setattr(self.pickplace_settings, key, value)
                self.logger.info(f"Updated {key} to {value}")

    async def safe_move_to_home_position(self) -> bool:
        """Move robot to a safe home position"""
        try:
            # Move to a safe neutral position within new shoulder range
            success = await self.move_cartesian(200, 0, 80)
            if success:
                await asyncio.sleep(0.5)
                # Open gripper
                await self.control_gripper(0)
            return success
        except Exception as e:
            self.logger.error(f"Failed to move to safe position: {e}")
            return False


class VisionSystem:
    """Enhanced computer vision system for object detection"""

    def __init__(self, settings: VisionSettings):
        self.settings = settings
        self.camera: Optional[cv2.VideoCapture] = None
        self.is_calibrated = False
        self.logger = logging.getLogger(__name__)

    def initialize_camera(self) -> bool:
        """Initialize camera"""
        try:
            self.camera = cv2.VideoCapture(self.settings.camera_index)

            if not self.camera.isOpened():
                raise Exception("Cannot open camera")

            self.camera.set(cv2.CAP_PROP_FRAME_WIDTH, self.settings.resolution[0])
            self.camera.set(cv2.CAP_PROP_FRAME_HEIGHT, self.settings.resolution[1])
            self.camera.set(cv2.CAP_PROP_FPS, 30)

            self.logger.info("Camera initialized successfully")
            return True

        except Exception as e:
            self.logger.error(f"Camera initialization failed: {e}")
            return False

    def release_camera(self):
        """Release camera resources"""
        if self.camera and self.camera.isOpened():
            self.camera.release()
            self.logger.info("Camera released")

    def capture_frame(self) -> Optional[np.ndarray]:
        """Capture a frame from camera"""
        if not self.camera or not self.camera.isOpened():
            return None

        ret, frame = self.camera.read()
        return frame if ret else None

    def detect_objects(self, frame: np.ndarray) -> Tuple[Optional[Tuple[float, float]], np.ndarray]:
        """Detect objects in frame using color-based detection"""
        if frame is None:
            return None, frame

        try:
            blurred = cv2.GaussianBlur(frame, (self.settings.blur_kernel, self.settings.blur_kernel), 0)

            hsv = cv2.cvtColor(blurred, cv2.COLOR_BGR2HSV)

            lower = np.array(self.settings.hsv_lower)
            upper = np.array(self.settings.hsv_upper)
            mask = cv2.inRange(hsv, lower, upper)

            mask = cv2.erode(mask, None, iterations=2)
            mask = cv2.dilate(mask, None, iterations=2)

            contours, _ = cv2.findContours(mask, cv2.RETR_EXTERNAL, cv2.CHAIN_APPROX_SIMPLE)

            if contours:
                largest_contour = max(contours, key=cv2.contourArea)

                if cv2.contourArea(largest_contour) > self.settings.min_contour_area:
                    M = cv2.moments(largest_contour)
                    if M["m00"] > 0:
                        cx = int(M["m10"] / M["m00"])
                        cy = int(M["m01"] / M["m00"])

                        cv2.circle(frame, (cx, cy), 10, (0, 255, 0), -1)
                        cv2.circle(frame, (cx, cy), 20, (0, 255, 255), 2)

                        world_coords = self.pixel_to_world(cx, cy)

                        if world_coords:
                            cv2.putText(frame, f"X: {world_coords[0]:.1f}mm, Y: {world_coords[1]:.1f}mm",
                                        (cx - 100, cy - 30), cv2.FONT_HERSHEY_SIMPLEX, 0.6, (0, 255, 0), 2)

                        return world_coords, frame

            return None, frame

        except Exception as e:
            self.logger.error(f"Object detection error: {e}")
            return None, frame

    def pixel_to_world(self, px: int, py: int) -> Optional[Tuple[float, float]]:
        """Convert pixel coordinates to world coordinates"""
        if self.settings.calibration_matrix is not None:
            pixel_point = np.array([[px, py]], dtype=np.float32).reshape(-1, 1, 2)
            world_point = cv2.perspectiveTransform(pixel_point, self.settings.calibration_matrix)
            return float(world_point[0][0][0]), float(world_point[0][0][1])
        else:
            x_mm = (px + self.settings.resolution[0] / 2) * 0.5
            y_mm = 430 - (py * 0.5)
            return x_mm, y_mm

    def update_color_settings(self, hsv_lower: List[int], hsv_upper: List[int]):
        """Update color detection settings"""
        self.settings.hsv_lower = hsv_lower
        self.settings.hsv_upper = hsv_upper


class DataLogger:
    """Enhanced data logging and analytics system with task persistence"""

    def __init__(self, db_path: str = "scara_robot.db"):
        self.db_path = db_path
        self.logger = logging.getLogger(__name__)
        self.init_database()

    def init_database(self):
        """Initialize SQLite database with task and sequence tables"""
        try:
            conn = sqlite3.connect(self.db_path)
            cursor = conn.cursor()

            cursor.execute('''
                CREATE TABLE IF NOT EXISTS movements (
                    id INTEGER PRIMARY KEY AUTOINCREMENT,
                    timestamp DATETIME DEFAULT CURRENT_TIMESTAMP,
                    x REAL, y REAL, z REAL, w REAL,
                    mode TEXT,
                    duration REAL,
                    success BOOLEAN
                )
            ''')

            cursor.execute('''
                CREATE TABLE IF NOT EXISTS system_events (
                    id INTEGER PRIMARY KEY AUTOINCREMENT,
                    timestamp DATETIME DEFAULT CURRENT_TIMESTAMP,
                    event_type TEXT,
                    description TEXT,
                    data TEXT
                )
            ''')

            cursor.execute('''
                CREATE TABLE IF NOT EXISTS task_executions (
                    id INTEGER PRIMARY KEY AUTOINCREMENT,
                    timestamp DATETIME DEFAULT CURRENT_TIMESTAMP,
                    task_name TEXT,
                    duration REAL,
                    success BOOLEAN,
                    error_message TEXT
                )
            ''')

            cursor.execute('''
                CREATE TABLE IF NOT EXISTS pickplace_operations (
                    id INTEGER PRIMARY KEY AUTOINCREMENT,
                    timestamp DATETIME DEFAULT CURRENT_TIMESTAMP,
                    pick_x REAL, pick_y REAL, pick_z REAL,
                    drop_x REAL, drop_y REAL, drop_z REAL,
                    duration REAL,
                    success BOOLEAN,
                    error_message TEXT
                )
            ''')

            # NEW: Tasks table for persistent task storage
            cursor.execute('''
                CREATE TABLE IF NOT EXISTS tasks (
                    id INTEGER PRIMARY KEY AUTOINCREMENT,
                    name TEXT UNIQUE NOT NULL,
                    steps TEXT NOT NULL,
                    created DATETIME DEFAULT CURRENT_TIMESTAMP,
                    modified DATETIME DEFAULT CURRENT_TIMESTAMP,
                    executions INTEGER DEFAULT 0,
                    last_executed DATETIME
                )
            ''')

            # NEW: Sequences table for persistent sequence storage
            cursor.execute('''
                CREATE TABLE IF NOT EXISTS sequences (
                    id INTEGER PRIMARY KEY AUTOINCREMENT,
                    name TEXT UNIQUE NOT NULL,
                    tasks TEXT NOT NULL,
                    loop_count INTEGER DEFAULT 1,
                    created DATETIME DEFAULT CURRENT_TIMESTAMP,
                    modified DATETIME DEFAULT CURRENT_TIMESTAMP,
                    executions INTEGER DEFAULT 0,
                    last_executed DATETIME
                )
            ''')

            conn.commit()
            conn.close()

            self.logger.info("Database initialized successfully with task persistence")

        except Exception as e:
            self.logger.error(f"Database initialization failed: {e}")

    def log_movement(self, x: float, y: float, z: float, w: float,
                     mode: str, duration: float, success: bool):
        """Log robot movement"""
        try:
            conn = sqlite3.connect(self.db_path)
            cursor = conn.cursor()

            cursor.execute('''
                INSERT INTO movements (x, y, z, w, mode, duration, success)
                VALUES (?, ?, ?, ?, ?, ?, ?)
            ''', (x, y, z, w, mode, duration, success))

            conn.commit()
            conn.close()

        except Exception as e:
            self.logger.error(f"Movement logging failed: {e}")

    def log_event(self, event_type: str, description: str, data: Optional[Dict] = None):
        """Log system event"""
        try:
            conn = sqlite3.connect(self.db_path)
            cursor = conn.cursor()

            data_json = json.dumps(data) if data else None

            cursor.execute('''
                INSERT INTO system_events (event_type, description, data)
                VALUES (?, ?, ?)
            ''', (event_type, description, data_json))

            conn.commit()
            conn.close()

        except Exception as e:
            self.logger.error(f"Event logging failed: {e}")

    def log_pickplace_operation(self, pick_x: float, pick_y: float, pick_z: float,
                                drop_x: float, drop_y: float, drop_z: float,
                                duration: float, success: bool, error_message: str = None):
        """Log pick and place operation"""
        try:
            conn = sqlite3.connect(self.db_path)
            cursor = conn.cursor()

            cursor.execute('''
                INSERT INTO pickplace_operations
                (pick_x, pick_y, pick_z, drop_x, drop_y, drop_z, duration, success, error_message)
                VALUES (?, ?, ?, ?, ?, ?, ?, ?, ?)
            ''', (pick_x, pick_y, pick_z, drop_x, drop_y, drop_z, duration, success, error_message))

            conn.commit()
            conn.close()

        except Exception as e:
            self.logger.error(f"Pick and place logging failed: {e}")

    # NEW: Task persistence methods
    def save_task(self, name: str, steps: List[Dict]) -> bool:
        """Save task to database"""
        try:
            conn = sqlite3.connect(self.db_path)
            cursor = conn.cursor()

            steps_json = json.dumps(steps)
            current_time = datetime.now().isoformat()

            cursor.execute('''
                INSERT OR REPLACE INTO tasks (name, steps, modified)
                VALUES (?, ?, ?)
            ''', (name, steps_json, current_time))

            conn.commit()
            conn.close()

            self.logger.info(f"Task '{name}' saved to database")
            return True

        except Exception as e:
            self.logger.error(f"Failed to save task '{name}': {e}")
            return False

    def load_task(self, name: str) -> Optional[Dict]:
        """Load specific task from database"""
        try:
            conn = sqlite3.connect(self.db_path)
            cursor = conn.cursor()

            cursor.execute('''
                SELECT name, steps, created, modified, executions, last_executed
                FROM tasks WHERE name = ?
            ''', (name,))

            result = cursor.fetchone()
            conn.close()

            if result:
                return {
                    'name': result[0],
                    'steps': json.loads(result[1]),
                    'created': result[2],
                    'modified': result[3],
                    'executions': result[4] or 0,
                    'last_executed': result[5]
                }

            return None

        except Exception as e:
            self.logger.error(f"Failed to load task '{name}': {e}")
            return None

    def load_all_tasks(self) -> Dict[str, Dict]:
        """Load all tasks from database"""
        try:
            conn = sqlite3.connect(self.db_path)
            cursor = conn.cursor()

            cursor.execute('''
                SELECT name, steps, created, modified, executions, last_executed
                FROM tasks ORDER BY created DESC
            ''')

            results = cursor.fetchall()
            conn.close()

            tasks = {}
            for result in results:
                try:
                    tasks[result[0]] = {
                        'name': result[0],
                        'steps': json.loads(result[1]),
                        'created': result[2],
                        'modified': result[3],
                        'executions': result[4] or 0,
                        'last_executed': result[5]
                    }
                except json.JSONDecodeError as e:
                    self.logger.error(f"Failed to parse steps for task '{result[0]}': {e}")
                    continue

            self.logger.info(f"Loaded {len(tasks)} tasks from database")
            return tasks

        except Exception as e:
            self.logger.error(f"Failed to load tasks: {e}")
            return {}

    def update_task_execution(self, name: str) -> bool:
        """Update task execution count and timestamp"""
        try:
            conn = sqlite3.connect(self.db_path)
            cursor = conn.cursor()

            current_time = datetime.now().isoformat()

            cursor.execute('''
                UPDATE tasks
                SET executions = executions + 1, last_executed = ?
                WHERE name = ?
            ''', (current_time, name))

            conn.commit()
            conn.close()

            return True

        except Exception as e:
            self.logger.error(f"Failed to update task execution for '{name}': {e}")
            return False

    def delete_task(self, name: str) -> bool:
        """Delete task from database"""
        try:
            conn = sqlite3.connect(self.db_path)
            cursor = conn.cursor()

            cursor.execute('DELETE FROM tasks WHERE name = ?', (name,))

            conn.commit()
            conn.close()

            self.logger.info(f"Task '{name}' deleted from database")
            return True

        except Exception as e:
            self.logger.error(f"Failed to delete task '{name}': {e}")
            return False

    # NEW: Sequence persistence methods
    def save_sequence(self, name: str, tasks: List[str], loop_count: int = 1) -> bool:
        """Save sequence to database"""
        try:
            conn = sqlite3.connect(self.db_path)
            cursor = conn.cursor()

            tasks_json = json.dumps(tasks)
            current_time = datetime.now().isoformat()

            cursor.execute('''
                INSERT OR REPLACE INTO sequences (name, tasks, loop_count, modified)
                VALUES (?, ?, ?, ?)
            ''', (name, tasks_json, loop_count, current_time))

            conn.commit()
            conn.close()

            self.logger.info(f"Sequence '{name}' saved to database")
            return True

        except Exception as e:
            self.logger.error(f"Failed to save sequence '{name}': {e}")
            return False

    def load_all_sequences(self) -> Dict[str, Dict]:
        """Load all sequences from database"""
        try:
            conn = sqlite3.connect(self.db_path)
            cursor = conn.cursor()

            cursor.execute('''
                SELECT name, tasks, loop_count, created, modified, executions, last_executed
                FROM sequences ORDER BY created DESC
            ''')

            results = cursor.fetchall()
            conn.close()

            sequences = {}
            for result in results:
                try:
                    sequences[result[0]] = {
                        'name': result[0],
                        'tasks': json.loads(result[1]),
                        'loop_count': result[2],
                        'created': result[3],
                        'modified': result[4],
                        'executions': result[5] or 0,
                        'last_executed': result[6]
                    }
                except json.JSONDecodeError as e:
                    self.logger.error(f"Failed to parse tasks for sequence '{result[0]}': {e}")
                    continue

            self.logger.info(f"Loaded {len(sequences)} sequences from database")
            return sequences

        except Exception as e:
            self.logger.error(f"Failed to load sequences: {e}")
            return {}

    def update_sequence_execution(self, name: str) -> bool:
        """Update sequence execution count and timestamp"""
        try:
            conn = sqlite3.connect(self.db_path)
            cursor = conn.cursor()

            current_time = datetime.now().isoformat()

            cursor.execute('''
                UPDATE sequences
                SET executions = executions + 1, last_executed = ?
                WHERE name = ?
            ''', (current_time, name))

            conn.commit()
            conn.close()

            return True

        except Exception as e:
            self.logger.error(f"Failed to update sequence execution for '{name}': {e}")
            return False

    def delete_sequence(self, name: str) -> bool:
        """Delete sequence from database"""
        try:
            conn = sqlite3.connect(self.db_path)
            cursor = conn.cursor()

            cursor.execute('DELETE FROM sequences WHERE name = ?', (name,))

            conn.commit()
            conn.close()

            self.logger.info(f"Sequence '{name}' deleted from database")
            return True

        except Exception as e:
            self.logger.error(f"Failed to delete sequence '{name}': {e}")
            return False

    def get_movement_history(self, limit: int = 100) -> List[Dict]:
        """Get recent movement history"""
        try:
            conn = sqlite3.connect(self.db_path)
            cursor = conn.cursor()

            cursor.execute('''
                SELECT timestamp, x, y, z, w, mode, duration, success
                FROM movements
                ORDER BY timestamp DESC
                LIMIT ?
            ''', (limit,))

            results = cursor.fetchall()
            conn.close()

            return [
                {
                    'timestamp': row[0],
                    'x': row[1], 'y': row[2], 'z': row[3], 'w': row[4],
                    'mode': row[5], 'duration': row[6], 'success': row[7]
                }
                for row in results
            ]

        except Exception as e:
            self.logger.error(f"Failed to get movement history: {e}")
            return []


class TaskManager:
    """Advanced task programming and execution system with persistence"""

    def __init__(self, robot_controller: RobotController, data_logger: DataLogger):
        self.robot = robot_controller
        self.data_logger = data_logger  # NEW: Add data logger reference
        self.tasks = {}
        self.current_task = None
        self.is_executing = False
        self.logger = logging.getLogger(__name__)

        # Task sequencing
        self.task_sequences = {}
        self.current_sequence = None
        self.is_executing_sequence = False
        self.sequence_thread = None
        self.sequence_stop_event = threading.Event()
        self.sequence_pause_event = threading.Event()

        # NEW: Load existing tasks and sequences from database on startup
        self.load_tasks_from_database()
        self.load_sequences_from_database()

    def load_tasks_from_database(self):
        """Load all tasks from database on startup"""
        try:
            self.tasks = self.data_logger.load_all_tasks()
            self.logger.info(f"Loaded {len(self.tasks)} tasks from database")
        except Exception as e:
            self.logger.error(f"Failed to load tasks from database: {e}")
            self.tasks = {}

    def load_sequences_from_database(self):
        """Load all sequences from database on startup"""
        try:
            self.task_sequences = self.data_logger.load_all_sequences()
            self.logger.info(f"Loaded {len(self.task_sequences)} sequences from database")
        except Exception as e:
            self.logger.error(f"Failed to load sequences from database: {e}")
            self.task_sequences = {}

    def create_task(self, name: str, steps: List[Dict]) -> bool:
        """Create a new task with immediate persistence"""
        try:
            validated_steps = []
            for step in steps:
                if self.validate_step(step):
                    validated_steps.append(step)
                else:
                    self.logger.error(f"Invalid step in task {name}: {step}")
                    return False

            # NEW: Save to database immediately
            success = self.data_logger.save_task(name, validated_steps)
            if not success:
                self.logger.error(f"Failed to save task '{name}' to database")
                return False

            # Update in-memory storage
            self.tasks[name] = {
                'name': name,
                'steps': validated_steps,
                'created': datetime.now().isoformat(),
                'executions': 0
            }

            self.logger.info(f"Task '{name}' created with {len(steps)} steps and saved to database")
            return True

        except Exception as e:
            self.logger.error(f"Task creation failed: {e}")
            return False

    def validate_step(self, step: Dict) -> bool:
        """Validate a task step with updated ranges"""
        required_fields = ['type']

        if not all(field in step for field in required_fields):
            return False

        step_type = step['type']

        if step_type == 'move_joint':
            if not all(key in step for key in ['shoulder', 'elbow', 'wrist', 'z']):
                return False
            # Validate ranges
            shoulder = step['shoulder']
            elbow = step['elbow']
            wrist = step['wrist']
            z = step['z']

            if not (0 <= shoulder <= 180):
                return False
            if not (-90 <= elbow <= 90):
                return False
            if not (-90 <= wrist <= 90):
                return False
            if not (0 <= z <= 300):
                return False

        elif step_type == 'move_cartesian':
            if not all(key in step for key in ['x', 'y', 'z']):
                return False
            # Check if position is reachable
            if not self.robot.is_position_reachable(step['x'], step['y'], step['z']):
                return False

        elif step_type == 'gripper':
            if 'position' not in step:
                return False
            if not (0 <= step['position'] <= 90):  # Updated range
                return False

        elif step_type == 'wait':
            return 'duration' in step and step['duration'] > 0

        elif step_type == 'pick_and_place':
            if not all(key in step for key in ['pick_x', 'pick_y']):
                return False
            # Check if pick position is reachable
            pick_z = step.get('pick_z', 50.0)
            if not self.robot.is_position_reachable(step['pick_x'], step['pick_y'], pick_z):
                return False

        return True

    async def execute_task(self, task_name: str) -> bool:
        """Execute a task with database logging"""
        if task_name not in self.tasks:
            self.logger.error(f"Task '{task_name}' not found")
            return False

        if self.is_executing:
            self.logger.error("Another task is already executing")
            return False

        self.is_executing = True
        self.current_task = task_name
        task = self.tasks[task_name]

        try:
            self.logger.info(f"Starting execution of task '{task_name}'")

            for i, step in enumerate(task['steps']):
                self.logger.info(f"Executing step {i + 1}/{len(task['steps'])}: {step['type']}")

                success = await self.execute_step(step)
                if not success:
                    self.logger.error(f"Step {i + 1} failed, aborting task")
                    return False

            # NEW: Update database execution count
            self.data_logger.update_task_execution(task_name)

            # Update in-memory count
            task['executions'] += 1
            task['last_executed'] = datetime.now().isoformat()

            self.logger.info(f"Task '{task_name}' completed successfully")
            return True

        except Exception as e:
            self.logger.error(f"Task execution failed: {e}")
            return False
        finally:
            self.is_executing = False
            self.current_task = None

    async def execute_step(self, step: Dict) -> bool:
        """Execute a single task step"""
        step_type = step['type']

        try:
            if step_type == 'move_joint':
                return await self.robot.move_joint(
                    step['shoulder'], step['elbow'], step['wrist'], step['z']
                )
            elif step_type == 'move_cartesian':
                return await self.robot.move_cartesian(step['x'], step['y'], step['z'])
            elif step_type == 'gripper':
                return await self.robot.control_gripper(step['position'])
            elif step_type == 'wait':
                await asyncio.sleep(step['duration'])
                return True
            elif step_type == 'pick_and_place':
                return await self.robot.pick_and_place(
                    step['pick_x'], step['pick_y'],
                    step.get('drop_x'), step.get('drop_y'), step.get('drop_z')
                )

            return False

        except Exception as e:
            self.logger.error(f"Step execution error: {e}")
            return False

    # === TASK SEQUENCING FUNCTIONALITY ===

    def create_sequence(self, name: str, task_names: List[str], loop_count: int = 1) -> bool:
        """Create a new task sequence with immediate persistence"""
        try:
            # Validate that all tasks exist
            for task_name in task_names:
                if task_name not in self.tasks:
                    self.logger.error(f"Task '{task_name}' not found for sequence")
                    return False

            # NEW: Save to database immediately
            success = self.data_logger.save_sequence(name, task_names, loop_count)
            if not success:
                self.logger.error(f"Failed to save sequence '{name}' to database")
                return False

            # Update in-memory storage
            self.task_sequences[name] = {
                'name': name,
                'tasks': task_names,
                'loop_count': loop_count,
                'created': datetime.now().isoformat(),
                'executions': 0,
                'last_executed': None
            }

            self.logger.info(
                f"Sequence '{name}' created with {len(task_names)} tasks, {loop_count} loops and saved to database")
            return True

        except Exception as e:
            self.logger.error(f"Sequence creation failed: {e}")
            return False

    def start_sequence(self, sequence_name: str, progress_callback=None) -> bool:
        """Start executing a task sequence"""
        if sequence_name not in self.task_sequences:
            self.logger.error(f"Sequence '{sequence_name}' not found")
            return False

        if self.is_executing_sequence:
            self.logger.error("Another sequence is already executing")
            return False

        self.current_sequence = sequence_name
        self.is_executing_sequence = True
        self.sequence_stop_event.clear()
        self.sequence_pause_event.clear()

        # Start sequence in background thread
        self.sequence_thread = threading.Thread(
            target=self._execute_sequence_background,
            args=(sequence_name, progress_callback),
            daemon=True
        )
        self.sequence_thread.start()
        return True

    def stop_sequence(self):
        """Stop the current sequence"""
        if self.is_executing_sequence:
            self.sequence_stop_event.set()
            self.logger.info("Sequence stop requested")

    def pause_sequence(self):
        """Pause the current sequence"""
        if self.is_executing_sequence:
            self.sequence_pause_event.set()
            self.logger.info("Sequence paused")

    def resume_sequence(self):
        """Resume the paused sequence"""
        if self.is_executing_sequence:
            self.sequence_pause_event.clear()
            self.logger.info("Sequence resumed")

    def _execute_sequence_background(self, sequence_name: str, progress_callback=None):
        """Execute sequence in background thread with database logging"""
        try:
            sequence = self.task_sequences[sequence_name]
            tasks = sequence['tasks']
            loop_count = sequence['loop_count']

            self.logger.info(f"Starting sequence '{sequence_name}' with {len(tasks)} tasks, {loop_count} loops")

            loop = asyncio.new_event_loop()
            asyncio.set_event_loop(loop)

            async def run_sequence():
                for current_loop in range(loop_count):
                    if self.sequence_stop_event.is_set():
                        self.logger.info("Sequence stopped by user")
                        break

                    self.logger.info(f"Starting loop {current_loop + 1}/{loop_count}")

                    for task_index, task_name in enumerate(tasks):
                        if self.sequence_stop_event.is_set():
                            self.logger.info("Sequence stopped by user")
                            break

                        # Handle pause
                        while self.sequence_pause_event.is_set():
                            if self.sequence_stop_event.is_set():
                                break
                            await asyncio.sleep(0.1)

                        if self.sequence_stop_event.is_set():
                            break

                        # Update progress
                        if progress_callback:
                            progress_callback({
                                'current_task': task_index,
                                'current_loop': current_loop,
                                'total_tasks': len(tasks),
                                'total_loops': loop_count,
                                'task_name': task_name,
                                'is_running': True,
                                'is_paused': self.sequence_pause_event.is_set()
                            })

                        # Execute task
                        self.logger.info(f"Executing task '{task_name}' (task {task_index + 1}/{len(tasks)})")
                        success = await self.execute_task(task_name)

                        if not success:
                            self.logger.error(f"Task '{task_name}' failed, stopping sequence")
                            break

                        # Small delay between tasks
                        await asyncio.sleep(0.5)

                    if self.sequence_stop_event.is_set():
                        break

                    # Delay between loops
                    if current_loop < loop_count - 1:
                        await asyncio.sleep(1.0)

                # NEW: Update database execution count
                self.data_logger.update_sequence_execution(sequence_name)

                # Update in-memory statistics
                sequence['executions'] += 1
                sequence['last_executed'] = datetime.now().isoformat()

                self.logger.info(f"Sequence '{sequence_name}' completed")

            # Run the async sequence
            loop.run_until_complete(run_sequence())

        except Exception as e:
            self.logger.error(f"Sequence execution error: {e}")
        finally:
            self.is_executing_sequence = False
            self.current_sequence = None
            loop.close()

            # Final progress update
            if progress_callback:
                progress_callback({
                    'current_task': 0,
                    'current_loop': 0,
                    'total_tasks': 0,
                    'total_loops': 0,
                    'task_name': '',
                    'is_running': False,
                    'is_paused': False
                })

    def get_sequence_status(self) -> Dict:
        """Get current sequence execution status"""
        return {
            'is_executing': self.is_executing_sequence,
            'current_sequence': self.current_sequence,
            'is_paused': self.sequence_pause_event.is_set() if self.is_executing_sequence else False
        }

    # NEW: Delete methods with database persistence
    def delete_task(self, task_name: str) -> bool:
        """Delete task from both memory and database"""
        try:
            # Remove from database
            success = self.data_logger.delete_task(task_name)
            if not success:
                self.logger.error(f"Failed to delete task '{task_name}' from database")
                return False

            # Remove from memory
            if task_name in self.tasks:
                del self.tasks[task_name]
                self.logger.info(f"Task '{task_name}' deleted from memory and database")
                return True
            else:
                self.logger.warning(f"Task '{task_name}' not found in memory")
                return True  # Still successful if removed from database

        except Exception as e:
            self.logger.error(f"Failed to delete task '{task_name}': {e}")
            return False

    def delete_sequence(self, sequence_name: str) -> bool:
        """Delete sequence from both memory and database"""
        try:
            # Remove from database
            success = self.data_logger.delete_sequence(sequence_name)
            if not success:
                self.logger.error(f"Failed to delete sequence '{sequence_name}' from database")
                return False

            # Remove from memory
            if sequence_name in self.task_sequences:
                del self.task_sequences[sequence_name]
                self.logger.info(f"Sequence '{sequence_name}' deleted from memory and database")
                return True
            else:
                self.logger.warning(f"Sequence '{sequence_name}' not found in memory")
                return True  # Still successful if removed from database

        except Exception as e:
            self.logger.error(f"Failed to delete sequence '{sequence_name}': {e}")
            return False


class SCARAWebApp:
    """Main Flask application with SocketIO"""

    def __init__(self):
        self.app = Flask(__name__)
        self.app.config['SECRET_KEY'] = 'scara_robot_secret_key'
        self.socketio = SocketIO(self.app, cors_allowed_origins="*")

        self.config = RobotConfig()
        self.motion_settings = MotionSettings()
        self.vision_settings = VisionSettings()
        self.system_state = SystemState()

        self.robot = RobotController(self.config)
        self.vision = VisionSystem(self.vision_settings)

        # NEW: Pass data_logger to TaskManager
        self.data_logger = DataLogger()
        self.task_manager = TaskManager(self.robot, self.data_logger)

        # Pick and place state
        self.last_detection_time = 0
        self.detection_cooldown = 3.0  # Seconds between automatic pick operations

        # Auto mode integration
        self.auto_mode_active = False

        logging.basicConfig(
            level=logging.INFO,
            format='%(asctime)s - %(name)s - %(levelname)s - %(message)s',
            handlers=[
                logging.FileHandler('logs/scara_robot.log'),
                logging.StreamHandler()
            ]
        )
        self.logger = logging.getLogger(__name__)

        self.setup_routes()
        self.setup_socket_events()

        self.start_background_tasks()

    def setup_routes(self):
        """Setup Flask routes"""

        # Add CORS headers to all responses
        @self.app.after_request
        def after_request(response):
            response.headers.add('Access-Control-Allow-Origin', '*')
            response.headers.add('Access-Control-Allow-Headers', 'Content-Type,Authorization')
            response.headers.add('Access-Control-Allow-Methods', 'GET,PUT,POST,DELETE,OPTIONS')
            return response

        # Add error handler
        @self.app.errorhandler(Exception)
        def handle_exception(e):
            self.logger.error(f"Unhandled exception: {str(e)}")
            return jsonify({
                'success': False,
                'error': f'Server error: {str(e)}'
            }), 500

        @self.app.route('/')
        def index():
            # Return the HTML template directly since we're not using external template files
            return self.get_html_template()

        @self.app.route('/api/ports')
        def list_serial_ports():
            """List available serial ports"""
            try:
                import serial.tools.list_ports
                ports = []

                for port in serial.tools.list_ports.comports():
                    ports.append({
                        'device': port.device,
                        'name': port.name,
                        'description': port.description,
                        'hwid': port.hwid,
                        'manufacturer': getattr(port, 'manufacturer', 'Unknown')
                    })

                return jsonify({'success': True, 'ports': ports})
            except Exception as e:
                return jsonify({'success': False, 'error': str(e)})

        @self.app.route('/api/connect', methods=['POST'])
        def connect():
            try:
                data = request.get_json() or {}
                port = data.get('port', '/dev/ttyUSB0')
                self.robot.port = port

                loop = asyncio.new_event_loop()
                asyncio.set_event_loop(loop)
                success = loop.run_until_complete(self.robot.connect())
                loop.close()

                if success:
                    self.system_state.is_connected = True
                    self.data_logger.log_event("SYSTEM", "Robot connected")

                return jsonify({'success': success})
            except Exception as e:
                return jsonify({'success': False, 'error': str(e)})

        @self.app.route('/api/disconnect', methods=['POST'])
        def disconnect():
            try:
                loop = asyncio.new_event_loop()
                asyncio.set_event_loop(loop)
                loop.run_until_complete(self.robot.disconnect())
                loop.close()

                self.system_state.is_connected = False
                self.data_logger.log_event("SYSTEM", "Robot disconnected")
                return jsonify({'success': True})
            except Exception as e:
                return jsonify({'success': False, 'error': str(e)})

        @self.app.route('/api/home', methods=['POST'])
        def home():
            try:
                self.logger.info("Homing request received from web interface")

                if not self.system_state.is_connected:
                    error_msg = "Robot not connected"
                    self.logger.warning(error_msg)
                    return jsonify({'success': False, 'error': error_msg})

                if self.system_state.emergency_stop:
                    error_msg = "Cannot home - emergency stop is active"
                    self.logger.error(error_msg)
                    return jsonify({'success': False, 'error': error_msg})

                self.logger.info("Initiating homing sequence...")

                loop = asyncio.new_event_loop()
                asyncio.set_event_loop(loop)
                start_time = time.time()

                success = loop.run_until_complete(self.robot.home_robot())

                loop.close()
                homing_time = time.time() - start_time

                if success:
                    self.system_state.is_homed = True
                    self.system_state.current_position = [0.0, 0.0, 0.0, 0.0]  # Reset to home position

                    self.data_logger.log_event("MOTION", f"Robot homed successfully in {homing_time:.2f}s")
                    self.logger.info(f"Homing completed successfully in {homing_time:.2f}s")

                    return jsonify({
                        'success': True,
                        'message': 'Robot homed successfully',
                        'time': homing_time
                    })
                else:
                    error_msg = "Homing sequence failed"
                    self.logger.error(error_msg)
                    self.data_logger.log_event("MOTION", f"Homing failed after {homing_time:.2f}s")

                    return jsonify({'success': False, 'error': error_msg, 'time': homing_time})

            except Exception as e:
                error_msg = f"Homing error: {str(e)}"
                self.logger.error(error_msg)
                return jsonify({'success': False, 'error': error_msg})

        @self.app.route('/api/settings/motion', methods=['POST'])
        def update_motion_settings():
            try:
                data = request.get_json()
                speed = data.get('speed', self.motion_settings.max_speed)
                acceleration = data.get('acceleration', self.motion_settings.acceleration)

                self.motion_settings.max_speed = speed
                self.motion_settings.acceleration = acceleration

                loop = asyncio.new_event_loop()
                asyncio.set_event_loop(loop)
                success = loop.run_until_complete(self.robot.set_motion_settings(speed, acceleration))
                loop.close()

                if success:
                    self.data_logger.log_event("SETTINGS",
                                               f"Motion settings updated: speed={speed}%, accel={acceleration}%")

                return jsonify({'success': success})
            except Exception as e:
                return jsonify({'success': False, 'error': str(e)})

        @self.app.route('/api/settings/vision', methods=['POST'])
        def update_vision_settings():
            try:
                data = request.get_json()
                hsv_lower = data.get('hsv_lower', self.vision_settings.hsv_lower)
                hsv_upper = data.get('hsv_upper', self.vision_settings.hsv_upper)

                self.vision.update_color_settings(hsv_lower, hsv_upper)
                self.data_logger.log_event("SETTINGS", f"Vision settings updated")

                return jsonify({'success': True})
            except Exception as e:
                return jsonify({'success': False, 'error': str(e)})

        @self.app.route('/api/move/joint', methods=['POST'])
        def move_joint():
            try:
                data = request.get_json()
                self.logger.info(f"Joint movement request received: {data}")

                required_fields = ['shoulder', 'elbow', 'wrist', 'z']
                for field in required_fields:
                    if field not in data:
                        error_msg = f"Missing required field: {field}"
                        self.logger.error(error_msg)
                        return jsonify({'success': False, 'error': error_msg})

                if not self.system_state.is_connected:
                    error_msg = "Robot not connected"
                    self.logger.warning(error_msg)
                    return jsonify({'success': False, 'error': error_msg})

                if self.system_state.emergency_stop:
                    error_msg = "Emergency stop is active"
                    self.logger.error(error_msg)
                    return jsonify({'success': False, 'error': error_msg})

                shoulder = float(data['shoulder'])
                elbow = float(data['elbow'])
                wrist = float(data['wrist'])
                z = float(data['z'])

                self.logger.info(f"Moving to joint position: S={shoulder}°, E={elbow}°, W={wrist}°, Z={z}mm")

                loop = asyncio.new_event_loop()
                asyncio.set_event_loop(loop)
                start_time = time.time()

                success = loop.run_until_complete(self.robot.move_joint(shoulder, elbow, wrist, z))

                loop.close()
                movement_time = time.time() - start_time

                if success:
                    self.logger.info(f"Joint movement completed successfully in {movement_time:.2f}s")

                    self.data_logger.log_movement(
                        data.get('x', 0), data.get('y', 0), z, wrist,
                        "manual_joint", movement_time, True
                    )

                    self.system_state.current_position = [shoulder, elbow, wrist, z]

                    return jsonify({'success': True, 'message': 'Joint movement completed', 'time': movement_time})
                else:
                    if not self.system_state.is_homed:
                        error_msg = "Robot needs to be homed first. Click the 'Home' button."
                        self.logger.warning(error_msg)
                        return jsonify({'success': False, 'error': error_msg, 'needs_homing': True})
                    else:
                        error_msg = "Joint movement failed - robot rejected command"
                        self.logger.error(error_msg)
                        return jsonify({'success': False, 'error': error_msg})

            except ValueError as ve:
                error_msg = f"Invalid numeric value in request: {ve}"
                self.logger.error(error_msg)
                return jsonify({'success': False, 'error': error_msg})
            except Exception as e:
                error_msg = f"Joint movement error: {str(e)}"
                self.logger.error(error_msg)
                return jsonify({'success': False, 'error': error_msg})

        @self.app.route('/api/move/cartesian', methods=['POST'])
        def move_cartesian():
            try:
                data = request.get_json()
                self.logger.info(f"Received Cartesian move command: {data}")
                loop = asyncio.new_event_loop()
                asyncio.set_event_loop(loop)
                success = loop.run_until_complete(self.robot.move_cartesian(data['x'], data['y'], data['z']))
                loop.close()

                if success:
                    self.data_logger.log_movement(
                        data['x'], data['y'], data['z'], 0,
                        "manual", 0, True
                    )

                return jsonify({'success': success})
            except Exception as e:
                return jsonify({'success': False, 'error': str(e)})

        @self.app.route('/api/gripper', methods=['POST'])
        def control_gripper():
            try:
                data = request.get_json()
                position = data.get('position', 0)

                loop = asyncio.new_event_loop()
                asyncio.set_event_loop(loop)
                success = loop.run_until_complete(self.robot.control_gripper(position))
                loop.close()

                if success:
                    self.system_state.gripper_position = position

                return jsonify({'success': success})
            except Exception as e:
                return jsonify({'success': False, 'error': str(e)})

        @self.app.route('/api/emergency', methods=['POST'])
        def emergency_stop():
            try:
                loop = asyncio.new_event_loop()
                asyncio.set_event_loop(loop)
                success = loop.run_until_complete(self.robot.emergency_stop())
                loop.close()

                if success:
                    self.system_state.emergency_stop = True
                    self.data_logger.log_event("SAFETY", "Emergency stop activated")

                return jsonify({'success': success})
            except Exception as e:
                return jsonify({'success': False, 'error': str(e)})

        @self.app.route('/api/reset', methods=['POST'])
        def reset_emergency():
            try:
                loop = asyncio.new_event_loop()
                asyncio.set_event_loop(loop)
                success = loop.run_until_complete(self.robot.reset_emergency())
                loop.close()

                if success:
                    self.system_state.emergency_stop = False
                    self.data_logger.log_event("SAFETY", "Emergency stop reset")

                return jsonify({'success': success})
            except Exception as e:
                return jsonify({'success': False, 'error': str(e)})

        @self.app.route('/api/status')
        def get_status():
            try:
                loop = asyncio.new_event_loop()
                asyncio.set_event_loop(loop)
                robot_status = loop.run_until_complete(self.robot.get_status())
                position = loop.run_until_complete(self.robot.get_position())
                loop.close()

                if position:
                    self.system_state.current_position = position

                return jsonify({
                    'system_state': asdict(self.system_state),
                    'robot_status': robot_status,
                    'position': position,
                    'motion_settings': asdict(self.motion_settings),
                    'vision_settings': asdict(self.vision_settings),
                    'pickplace_settings': asdict(self.robot.pickplace_settings)
                })
            except Exception as e:
                return jsonify({'error': str(e)})

        @self.app.route('/video_feed')
        def video_feed():
            return Response(
                self.generate_video_frames(),
                mimetype='multipart/x-mixed-replace; boundary=frame'
            )

        # NEW: Enhanced task routes with persistence
        @self.app.route('/api/tasks', methods=['GET'])
        def get_tasks():
            """Get all tasks from memory (already loaded from database)"""
            return jsonify(self.task_manager.tasks)

        @self.app.route('/api/tasks', methods=['POST'])
        def create_task():
            """Create new task with immediate database persistence"""
            try:
                data = request.get_json()

                if not data:
                    return jsonify({'success': False, 'error': 'No data provided'})

                if 'name' not in data or 'steps' not in data:
                    return jsonify({'success': False, 'error': 'Missing required fields: name or steps'})

                task_name = data['name'].strip()
                if not task_name:
                    return jsonify({'success': False, 'error': 'Task name cannot be empty'})

                steps = data['steps']
                if not isinstance(steps, list) or len(steps) == 0:
                    return jsonify({'success': False, 'error': 'Steps must be a non-empty list'})

                self.logger.info(f"Creating task '{task_name}' with {len(steps)} steps")

                # This will now save to database immediately
                success = self.task_manager.create_task(task_name, steps)

                if success:
                    self.logger.info(f"Task '{task_name}' created and saved successfully")
                    return jsonify({'success': True, 'message': f'Task "{task_name}" created and saved'})
                else:
                    self.logger.error(f"Failed to create task '{task_name}'")
                    return jsonify({'success': False, 'error': 'Failed to create and save task'})

            except Exception as e:
                self.logger.error(f"Task creation error: {str(e)}")
                return jsonify({'success': False, 'error': str(e)})

        @self.app.route('/api/tasks/<task_name>/execute', methods=['POST'])
        def execute_task(task_name):
            """Execute task with database logging"""
            try:
                loop = asyncio.new_event_loop()
                asyncio.set_event_loop(loop)
                success = loop.run_until_complete(self.task_manager.execute_task(task_name))
                loop.close()
                return jsonify({'success': success})
            except Exception as e:
                return jsonify({'success': False, 'error': str(e)})

        # NEW: Task deletion route
        @self.app.route('/api/tasks/<task_name>', methods=['DELETE'])
        def delete_task(task_name):
            """Delete task from both memory and database"""
            try:
                success = self.task_manager.delete_task(task_name)
                if success:
                    return jsonify({'success': True, 'message': f'Task "{task_name}" deleted'})
                else:
                    return jsonify({'success': False, 'error': 'Failed to delete task'})
            except Exception as e:
                return jsonify({'success': False, 'error': str(e)})

        @self.app.route('/api/analytics/movements')
        def get_movement_analytics():
            try:
                history = self.data_logger.get_movement_history(200)
                return jsonify(history)
            except Exception as e:
                return jsonify({'error': str(e)})

        # === PICK AND PLACE ROUTES ===

        @self.app.route('/api/pick_and_place/toggle', methods=['POST'])
        def toggle_pick_and_place():
            try:
                data = request.get_json() or {}
                enable = data.get('enable', not self.system_state.pick_and_place_enabled)

                self.system_state.pick_and_place_enabled = enable

                if enable:
                    self.data_logger.log_event("PICKPLACE", "Pick and place mode enabled")
                    message = "Pick and place mode enabled"
                else:
                    self.data_logger.log_event("PICKPLACE", "Pick and place mode disabled")
                    message = "Pick and place mode disabled"

                return jsonify({'success': True, 'enabled': enable, 'message': message})
            except Exception as e:
                return jsonify({'success': False, 'error': str(e)})

        @self.app.route('/api/pick_and_place/execute', methods=['POST'])
        def execute_pick_and_place():
            try:
                data = request.get_json()

                if not self.system_state.is_connected:
                    return jsonify({'success': False, 'error': 'Robot not connected'})

                if not self.system_state.is_homed:
                    return jsonify({'success': False, 'error': 'Robot not homed'})

                if self.system_state.is_executing_pickplace:
                    return jsonify({'success': False, 'error': 'Pick and place operation already in progress'})

                # Get coordinates
                pick_x = float(data.get('pick_x', 200))
                pick_y = float(data.get('pick_y', 0))
                drop_x = float(data.get('drop_x', 20))
                drop_y = float(data.get('drop_y', 10))
                drop_z = float(data.get('drop_z', 20))

                self.system_state.is_executing_pickplace = True

                def run_pickplace():
                    loop = asyncio.new_event_loop()
                    asyncio.set_event_loop(loop)
                    start_time = time.time()

                    try:
                        success = loop.run_until_complete(
                            self.robot.pick_and_place(pick_x, pick_y, drop_x, drop_y, drop_z)
                        )
                        duration = time.time() - start_time

                        # Log the operation
                        self.data_logger.log_pickplace_operation(
                            pick_x, pick_y, self.robot.pickplace_settings.pick_z_height,
                            drop_x, drop_y, drop_z, duration, success
                        )

                        # Emit status update
                        self.socketio.emit('pickplace_complete', {
                            'success': success,
                            'duration': duration,
                            'pick_coords': [pick_x, pick_y],
                            'drop_coords': [drop_x, drop_y, drop_z]
                        })

                    except Exception as e:
                        self.logger.error(f"Pick and place execution error: {e}")
                        self.socketio.emit('pickplace_complete', {
                            'success': False,
                            'error': str(e)
                        })
                    finally:
                        self.system_state.is_executing_pickplace = False
                        loop.close()

                # Run in background thread
                thread = threading.Thread(target=run_pickplace)
                thread.daemon = True
                thread.start()

                return jsonify({'success': True, 'message': 'Pick and place operation started'})

            except Exception as e:
                self.system_state.is_executing_pickplace = False
                return jsonify({'success': False, 'error': str(e)})

        @self.app.route('/api/pick_and_place/settings', methods=['GET', 'POST'])
        def pickplace_settings():
            if request.method == 'POST':
                try:
                    data = request.get_json()
                    self.robot.update_pickplace_settings(**data)
                    return jsonify({'success': True, 'message': 'Settings updated'})
                except Exception as e:
                    return jsonify({'success': False, 'error': str(e)})
            else:
                return jsonify(asdict(self.robot.pickplace_settings))

        @self.app.route('/api/pick_and_place/auto_pick', methods=['POST'])
        def auto_pick_detected_object():
            """Automatically pick up the last detected object"""
            try:
                if not self.system_state.is_connected or not self.system_state.is_homed:
                    return jsonify({'success': False, 'error': 'Robot not ready'})

                if not self.system_state.last_detection:
                    return jsonify({'success': False, 'error': 'No object detected'})

                if self.system_state.is_executing_pickplace:
                    return jsonify({'success': False, 'error': 'Pick and place already in progress'})

                pick_x, pick_y = self.system_state.last_detection

                self.system_state.is_executing_pickplace = True

                def run_auto_pickplace():
                    loop = asyncio.new_event_loop()
                    asyncio.set_event_loop(loop)
                    start_time = time.time()

                    try:
                        success = loop.run_until_complete(self.robot.pick_and_place(pick_x, pick_y))
                        duration = time.time() - start_time

                        self.data_logger.log_pickplace_operation(
                            pick_x, pick_y, self.robot.pickplace_settings.pick_z_height,
                            self.robot.pickplace_settings.drop_x,
                            self.robot.pickplace_settings.drop_y,
                            self.robot.pickplace_settings.drop_z,
                            duration, success,
                            None if success else "Auto pick operation failed"
                        )

                        self.socketio.emit('pickplace_complete', {
                            'success': success,
                            'duration': duration,
                            'auto_mode': True,
                            'pick_coords': [pick_x, pick_y]
                        })

                    except Exception as e:
                        self.logger.error(f"Auto pick operation error: {e}")
                        self.socketio.emit('pickplace_complete', {
                            'success': False,
                            'error': str(e),
                            'auto_mode': True
                        })
                    finally:
                        self.system_state.is_executing_pickplace = False
                        loop.close()

                thread = threading.Thread(target=run_auto_pickplace)
                thread.daemon = True
                thread.start()

                return jsonify({'success': True, 'message': 'Auto pick operation started'})

            except Exception as e:
                self.system_state.is_executing_pickplace = False
                return jsonify({'success': False, 'error': str(e)})

        # === ENHANCED TASK SEQUENCING ROUTES ===

        @self.app.route('/api/sequences', methods=['GET'])
        def get_sequences():
            """Get all task sequences from memory (already loaded from database)"""
            return jsonify(self.task_manager.task_sequences)

        @self.app.route('/api/sequences', methods=['POST'])
        def create_sequence():
            """Create a new task sequence with immediate database persistence"""
            try:
                data = request.get_json()

                if not data:
                    return jsonify({'success': False, 'error': 'No data provided'})

                name = data.get('name', '').strip()
                tasks = data.get('tasks', [])
                loop_count = data.get('loop_count', 1)

                if not name:
                    return jsonify({'success': False, 'error': 'Sequence name is required'})

                if not tasks or not isinstance(tasks, list):
                    return jsonify({'success': False, 'error': 'At least one task is required'})

                self.logger.info(f"Creating sequence '{name}' with {len(tasks)} tasks, {loop_count} loops")

                # This will now save to database immediately
                success = self.task_manager.create_sequence(name, tasks, loop_count)

                if success:
                    self.logger.info(f"Sequence '{name}' created and saved successfully")
                    return jsonify({'success': True, 'message': f'Sequence "{name}" created and saved'})
                else:
                    self.logger.error(f"Failed to create sequence '{name}'")
                    return jsonify({'success': False, 'error': 'Failed to create and save sequence'})

            except Exception as e:
                self.logger.error(f"Sequence creation error: {str(e)}")
                return jsonify({'success': False, 'error': str(e)})

        @self.app.route('/api/sequences/<sequence_name>/start', methods=['POST'])
        def start_sequence(sequence_name):
            """Start executing a task sequence"""
            try:
                if not self.system_state.is_connected or not self.system_state.is_homed:
                    return jsonify({'success': False, 'error': 'Robot not ready'})

                def progress_callback(progress):
                    self.system_state.sequence_progress = progress
                    self.system_state.is_executing_sequence = progress['is_running']
                    self.system_state.current_sequence_task = progress.get('task_name', '')
                    self.socketio.emit('sequence_progress', progress)

                success = self.task_manager.start_sequence(sequence_name, progress_callback)
                if success:
                    self.system_state.is_executing_sequence = True
                    return jsonify({'success': True, 'message': f'Sequence {sequence_name} started'})
                else:
                    return jsonify({'success': False, 'error': 'Failed to start sequence'})
            except Exception as e:
                return jsonify({'success': False, 'error': str(e)})

        @self.app.route('/api/sequences/stop', methods=['POST'])
        def stop_sequence():
            """Stop the current sequence"""
            try:
                self.task_manager.stop_sequence()
                self.system_state.is_executing_sequence = False
                return jsonify({'success': True, 'message': 'Sequence stop requested'})
            except Exception as e:
                return jsonify({'success': False, 'error': str(e)})

        @self.app.route('/api/sequences/pause', methods=['POST'])
        def pause_sequence():
            """Pause the current sequence"""
            try:
                self.task_manager.pause_sequence()
                return jsonify({'success': True, 'message': 'Sequence paused'})
            except Exception as e:
                return jsonify({'success': False, 'error': str(e)})

        @self.app.route('/api/sequences/resume', methods=['POST'])
        def resume_sequence():
            """Resume the paused sequence"""
            try:
                self.task_manager.resume_sequence()
                return jsonify({'success': True, 'message': 'Sequence resumed'})
            except Exception as e:
                return jsonify({'success': False, 'error': str(e)})

        @self.app.route('/api/sequences/<sequence_name>', methods=['DELETE'])
        def delete_sequence(sequence_name):
            """Delete a task sequence from both memory and database"""
            try:
                success = self.task_manager.delete_sequence(sequence_name)
                if success:
                    return jsonify({'success': True, 'message': f'Sequence "{sequence_name}" deleted'})
                else:
                    return jsonify({'success': False, 'error': 'Failed to delete sequence'})
            except Exception as e:
                return jsonify({'success': False, 'error': str(e)})

        @self.app.route('/api/sequences/status')
        def get_sequence_status():
            """Get current sequence execution status"""
            try:
                status = self.task_manager.get_sequence_status()
                status.update({
                    'progress': self.system_state.sequence_progress
                })
                return jsonify(status)
            except Exception as e:
                return jsonify({'error': str(e)})

        # === INVERSE KINEMATICS TESTING ROUTE ===

        @self.app.route('/api/kinematics/inverse', methods=['POST'])
        def test_inverse_kinematics():
            """Test inverse kinematics calculation"""
            try:
                data = request.get_json()
                x = float(data.get('x', 200))
                y = float(data.get('y', 0))
                z = float(data.get('z', 50))

                success, theta1, theta2, phi, final_z = self.robot.inverse_kinematics(x, y, z)

                if success:
                    # Also calculate forward kinematics for verification
                    verify_x, verify_y = self.robot.forward_kinematics(theta1, theta2, phi)
                    error = math.sqrt((x - verify_x) ** 2 + (y - verify_y) ** 2)

                    return jsonify({
                        'success': True,
                        'target': {'x': x, 'y': y, 'z': z},
                        'solution': {
                            'theta1': theta1,
                            'theta2': theta2,
                            'phi': phi,
                            'z': final_z
                        },
                        'verification': {'x': verify_x, 'y': verify_y},
                        'error': error
                    })
                else:
                    return jsonify({
                        'success': False,
                        'error': f'Position ({x:.1f}, {y:.1f}, {z:.1f}) is unreachable',
                        'target': {'x': x, 'y': y, 'z': z}
                    })

            except Exception as e:
                return jsonify({'success': False, 'error': str(e)})

        @self.app.route('/api/kinematics/forward', methods=['POST'])
        def test_forward_kinematics():
            """Test forward kinematics calculation"""
            try:
                data = request.get_json()
                theta1 = float(data.get('theta1', 0))
                theta2 = float(data.get('theta2', 0))
                phi = float(data.get('phi', 0))

                x, y = self.robot.forward_kinematics(theta1, theta2, phi)

                return jsonify({
                    'success': True,
                    'joints': {'theta1': theta1, 'theta2': theta2, 'phi': phi},
                    'position': {'x': x, 'y': y}
                })

            except Exception as e:
                return jsonify({'success': False, 'error': str(e)})

        # === REACHABILITY CHECK ROUTE ===

        @self.app.route('/api/kinematics/reachable', methods=['POST'])
        def check_reachability():
            """Check if a position is reachable"""
            try:
                data = request.get_json()
                x = float(data.get('x', 200))
                y = float(data.get('y', 0))
                z = float(data.get('z', 50))

                is_reachable = self.robot.is_position_reachable(x, y, z)

                return jsonify({
                    'success': True,
                    'position': {'x': x, 'y': y, 'z': z},
                    'reachable': is_reachable,
                    'max_reach': self.robot.config.max_reach,
                    'min_reach': self.robot.config.min_reach,
                    'z_limits': {'min': 0, 'max': self.robot.config.max_z_height}
                })

            except Exception as e:
                return jsonify({'success': False, 'error': str(e)})

        # === ENHANCED MODE TOGGLE ===

        @self.app.route('/api/mode/toggle', methods=['POST', 'OPTIONS'])
        def toggle_mode():
            """Toggle between manual and auto mode"""
            # Handle CORS preflight request
            if request.method == 'OPTIONS':
                response = jsonify({'status': 'OK'})
                response.headers.add('Access-Control-Allow-Origin', '*')
                response.headers.add('Access-Control-Allow-Headers', 'Content-Type,Authorization')
                response.headers.add('Access-Control-Allow-Methods', 'GET,PUT,POST,DELETE,OPTIONS')
                return response

            try:
                # Get JSON data safely
                data = request.get_json() if request.is_json else {}
                new_mode = data.get('mode') if data else None

                # Toggle mode logic
                if new_mode and new_mode in ['manual', 'auto']:
                    self.system_state.operation_mode = new_mode
                else:
                    # Toggle between current modes
                    self.system_state.operation_mode = 'auto' if self.system_state.operation_mode == 'manual' else 'manual'

                # Integrate with pick and place auto mode
                if self.system_state.operation_mode == 'auto':
                    self.auto_mode_active = True
                    # Enable pick and place mode automatically
                    self.system_state.pick_and_place_enabled = True
                    # Enable auto mode in pick and place settings
                    self.robot.pickplace_settings.auto_mode = True
                    message = "Auto mode enabled - will automatically pick and place detected objects"
                else:
                    self.auto_mode_active = False
                    # Disable auto mode in pick and place settings but keep pick and place enabled
                    self.robot.pickplace_settings.auto_mode = False
                    message = "Manual mode enabled - pick and place requires manual triggering"

                # Log the mode change
                self.data_logger.log_event("MODE", f"Mode switched to {self.system_state.operation_mode}")

                # Return success response
                response_data = {
                    'success': True,
                    'mode': self.system_state.operation_mode,
                    'message': message
                }

                response = jsonify(response_data)
                response.headers.add('Access-Control-Allow-Origin', '*')
                return response

            except Exception as e:
                self.logger.error(f"Mode toggle error: {str(e)}")
                error_response = {
                    'success': False,
                    'error': f"Mode toggle failed: {str(e)}"
                }
                response = jsonify(error_response)
                response.headers.add('Access-Control-Allow-Origin', '*')
                return response, 500

    def setup_socket_events(self):
        """Setup SocketIO events"""

        @self.socketio.on('connect')
        def handle_connect():
            self.logger.info("Client connected")
            emit('system_status', asdict(self.system_state))

        @self.socketio.on('disconnect')
        def handle_disconnect():
            self.logger.info("Client disconnected")

        @self.socketio.on('request_status')
        def handle_status_request():
            emit('system_status', asdict(self.system_state))

    def generate_video_frames(self):
        """Generate video frames for streaming"""
        while True:
            frame = self.vision.capture_frame()
            if frame is not None:
                detection, processed_frame = self.vision.detect_objects(frame)

                if detection:
                    self.system_state.last_detection = detection
                    current_time = time.time()

                    # Emit detection event
                    self.socketio.emit('object_detected', {
                        'x': detection[0],
                        'y': detection[1],
                        'timestamp': current_time
                    })

                    # Auto pick and place if enabled (either through auto mode or pick and place auto mode)
                    should_auto_pick = (
                            (self.auto_mode_active or self.robot.pickplace_settings.auto_mode) and
                            self.system_state.pick_and_place_enabled and
                            not self.system_state.is_executing_pickplace and
                            not self.system_state.is_executing_sequence and
                            self.system_state.is_connected and
                            self.system_state.is_homed and
                            current_time - self.last_detection_time > self.detection_cooldown
                    )

                    if should_auto_pick:
                        self.last_detection_time = current_time
                        auto_mode_type = "Main Auto Mode" if self.auto_mode_active else "Pick&Place Auto Mode"
                        self.logger.info(
                            f"Auto-triggering pick and place for object at ({detection[0]:.1f}, {detection[1]:.1f}) via {auto_mode_type}")

                        # Start auto pick and place in background
                        def auto_pick():
                            try:
                                self.system_state.is_executing_pickplace = True
                                loop = asyncio.new_event_loop()
                                asyncio.set_event_loop(loop)
                                start_time = time.time()

                                success = loop.run_until_complete(
                                    self.robot.pick_and_place(detection[0], detection[1])
                                )
                                duration = time.time() - start_time

                                self.data_logger.log_pickplace_operation(
                                    detection[0], detection[1], self.robot.pickplace_settings.pick_z_height,
                                    self.robot.pickplace_settings.drop_x,
                                    self.robot.pickplace_settings.drop_y,
                                    self.robot.pickplace_settings.drop_z,
                                    duration, success,
                                    None if success else "Auto pick failed"
                                )

                                self.socketio.emit('pickplace_complete', {
                                    'success': success,
                                    'duration': duration,
                                    'auto_triggered': True,
                                    'auto_mode_type': auto_mode_type,
                                    'pick_coords': detection
                                })

                            except Exception as e:
                                self.logger.error(f"Auto pick and place error: {e}")
                            finally:
                                self.system_state.is_executing_pickplace = False
                                loop.close()

                        thread = threading.Thread(target=auto_pick)
                        thread.daemon = True
                        thread.start()

                _, buffer = cv2.imencode('.jpg', processed_frame,
                                         [cv2.IMWRITE_JPEG_QUALITY, 85])

                yield (b'--frame\r\n'
                       b'Content-Type: image/jpeg\r\n\r\n' + buffer.tobytes() + b'\r\n')

            time.sleep(0.033)  # ~30 FPS

    def start_background_tasks(self):
        """Start background monitoring tasks"""

        def status_monitor():
            """Monitor robot status in background"""
            while True:
                try:
                    if self.system_state.is_connected:
                        loop = asyncio.new_event_loop()
                        asyncio.set_event_loop(loop)
                        status = loop.run_until_complete(self.robot.get_status())
                        position = loop.run_until_complete(self.robot.get_position())
                        loop.close()

                        if status:
                            self.system_state.emergency_stop = status.get('emergency', '0') == '1'
                            self.system_state.is_homed = status.get('homed', '0') == '1'
                            self.system_state.motors_enabled = status.get('motors', '0') == '1'

                        if position:
                            self.system_state.current_position = position

                        self.socketio.emit('status_update', asdict(self.system_state))

                except Exception as e:
                    self.logger.error(f"Status monitor error: {e}")

                time.sleep(1)

        status_thread = threading.Thread(target=status_monitor, daemon=True)
        status_thread.start()

        self.vision.initialize_camera()

    def get_html_template(self):
        """Return the Enhanced Professional HTML template"""
        return '''<!DOCTYPE html>
<html lang="en" class="h-full">
<head>
    <meta charset="UTF-8">
    <meta name="viewport" content="width=device-width, initial-scale=1.0">
    <title>SCARA PRO - Advanced Robotic Control System</title>

    <!-- External Libraries -->
    <script src="https://cdnjs.cloudflare.com/ajax/libs/socket.io/4.7.2/socket.io.js"></script>
    <script src="https://cdn.jsdelivr.net/npm/chart.js"></script>
    <script src="https://cdnjs.cloudflare.com/ajax/libs/three.js/r128/three.min.js"></script>
    <link rel="stylesheet" href="https://cdnjs.cloudflare.com/ajax/libs/font-awesome/6.4.0/css/all.min.css">
    <script src="https://cdn.tailwindcss.com"></script>

    <style>
        :root {
            --primary-gradient: linear-gradient(135deg, #667eea 0%, #764ba2 100%);
            --secondary-gradient: linear-gradient(135deg, #f093fb 0%, #f5576c 100%);
            --success-gradient: linear-gradient(135deg, #4facfe 0%, #00f2fe 100%);
            --warning-gradient: linear-gradient(135deg, #43e97b 0%, #38f9d7 100%);
            --danger-gradient: linear-gradient(135deg, #fa709a 0%, #fee140 100%);
            --dark-bg: #0f172a;
            --card-bg: rgba(255, 255, 255, 0.1);
            --glass-border: rgba(255, 255, 255, 0.2);
        }

        [data-theme="dark"] {
            --card-bg: rgba(15, 23, 42, 0.8);
            --glass-border: rgba(255, 255, 255, 0.1);
        }

        /* Enhanced Glassmorphism */
        .glass-card {
            background: var(--card-bg);
            backdrop-filter: blur(20px) saturate(180%);
            border: 1px solid var(--glass-border);
            box-shadow: 0 8px 32px rgba(31, 38, 135, 0.37);
            transition: all 0.3s ease;
        }

        .glass-card:hover {
            transform: translateY(-5px);
            box-shadow: 0 20px 50px rgba(31, 38, 135, 0.5);
        }

        /* Gradient Animations */
        .animated-gradient {
            background-size: 200% 200%;
            animation: gradientShift 3s ease infinite;
        }

        @keyframes gradientShift {
            0% { background-position: 0% 50%; }
            50% { background-position: 100% 50%; }
            100% { background-position: 0% 50%; }
        }

        /* Neon Effects */
        .neon-border {
            box-shadow: 0 0 20px rgba(102, 126, 234, 0.6);
            border: 2px solid rgba(102, 126, 234, 0.8);
        }

        .neon-text {
            text-shadow: 0 0 10px rgba(102, 126, 234, 0.8);
        }

        /* Enhanced Buttons */
        .btn-futuristic {
            position: relative;
            overflow: hidden;
            transition: all 0.3s ease;
        }

        .btn-futuristic::before {
            content: '';
            position: absolute;
            top: 0;
            left: -100%;
            width: 100%;
            height: 100%;
            background: linear-gradient(90deg, transparent, rgba(255,255,255,0.2), transparent);
            transition: left 0.5s;
        }

        .btn-futuristic:hover::before {
            left: 100%;
        }

        /* Status Indicators */
        .status-pulse {
            animation: pulse 2s infinite;
        }

        @keyframes pulse {
            0%, 100% { opacity: 1; }
            50% { opacity: 0.5; }
        }

        /* Custom Scrollbar */
        ::-webkit-scrollbar {
            width: 8px;
        }

        ::-webkit-scrollbar-track {
            background: rgba(255, 255, 255, 0.1);
            border-radius: 10px;
        }

        ::-webkit-scrollbar-thumb {
            background: var(--primary-gradient);
            border-radius: 10px;
        }

        /* Enhanced 3D Workspace */
        .workspace-3d {
            position: relative;
            border-radius: 20px;
            overflow: hidden;
            background: var(--primary-gradient);
            box-shadow: inset 0 0 50px rgba(0,0,0,0.3);
        }

        /* Holographic Display */
        .holographic {
            background: linear-gradient(45deg,
                rgba(0,255,255,0.1) 0%,
                rgba(255,0,255,0.1) 25%,
                rgba(255,255,0,0.1) 50%,
                rgba(0,255,255,0.1) 75%,
                rgba(255,0,255,0.1) 100%);
            border: 1px solid rgba(0,255,255,0.3);
            box-shadow: 0 0 30px rgba(0,255,255,0.2);
        }

        /* Data Visualization */
        .data-card {
            background: linear-gradient(135deg,
                rgba(255,255,255,0.1) 0%,
                rgba(255,255,255,0.05) 100%);
            border-left: 4px solid #00f2fe;
        }

        /* Enhanced Navigation */
        .nav-item {
            position: relative;
            transition: all 0.3s ease;
        }

        .nav-item::after {
            content: '';
            position: absolute;
            bottom: 0;
            left: 50%;
            width: 0;
            height: 2px;
            background: var(--primary-gradient);
            transition: all 0.3s ease;
            transform: translateX(-50%);
        }

        .nav-item.active::after,
        .nav-item:hover::after {
            width: 100%;
        }

        /* Enhanced Forms */
        .futuristic-input {
            background: rgba(255, 255, 255, 0.05);
            border: 1px solid rgba(255, 255, 255, 0.2);
            backdrop-filter: blur(10px);
            transition: all 0.3s ease;
        }

        .futuristic-input:focus {
            background: rgba(255, 255, 255, 0.1);
            border-color: #667eea;
            box-shadow: 0 0 20px rgba(102, 126, 234, 0.3);
        }

        /* Enhanced Sliders */
        .futuristic-slider {
            -webkit-appearance: none;
            height: 8px;
            border-radius: 5px;
            background: rgba(255, 255, 255, 0.2);
            outline: none;
        }

        .futuristic-slider::-webkit-slider-thumb {
            -webkit-appearance: none;
            appearance: none;
            width: 20px;
            height: 20px;
            border-radius: 50%;
            background: var(--primary-gradient);
            cursor: pointer;
            box-shadow: 0 0 10px rgba(102, 126, 234, 0.5);
        }

        /* Responsive Design */
        @media (max-width: 768px) {
            .grid-responsive {
                grid-template-columns: 1fr !important;
            }
        }

        /* Enhanced Notifications */
        .notification-modern {
            background: var(--card-bg);
            backdrop-filter: blur(20px);
            border-left: 4px solid;
            border-radius: 12px;
            box-shadow: 0 10px 30px rgba(0,0,0,0.3);
            transform: translateX(400px);
            animation: slideInNotification 0.5s ease forwards;
        }

        @keyframes slideInNotification {
            to { transform: translateX(0); }
        }

        /* Loading Animations */
        .loading-spinner {
            width: 40px;
            height: 40px;
            border: 4px solid rgba(255, 255, 255, 0.1);
            border-left: 4px solid #667eea;
            border-radius: 50%;
            animation: spin 1s linear infinite;
        }

        @keyframes spin {
            0% { transform: rotate(0deg); }
            100% { transform: rotate(360deg); }
        }

        /* Enhanced Charts */
        .chart-container {
            background: var(--card-bg);
            backdrop-filter: blur(20px);
            border-radius: 20px;
            padding: 20px;
        }

        /* Theme Toggle */
        .theme-toggle {
            position: fixed;
            top: 20px;
            right: 20px;
            width: 60px;
            height: 60px;
            border-radius: 50%;
            background: var(--primary-gradient);
            border: none;
            color: white;
            font-size: 24px;
            cursor: pointer;
            z-index: 1000;
            transition: all 0.3s ease;
            box-shadow: 0 5px 15px rgba(0,0,0,0.3);
        }

        .theme-toggle:hover {
            transform: scale(1.1) rotate(180deg);
        }

        /* Body and Background */
        body {
            background: var(--primary-gradient);
            min-height: 100vh;
            font-family: 'Inter', -apple-system, BlinkMacSystemFont, sans-serif;
        }

        [data-theme="dark"] body {
            background: linear-gradient(135deg, #0f172a 0%, #1e293b 100%);
        }
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
